thoryn-dev/Soundic-SD-01-Schematic/curves/chrominance.png

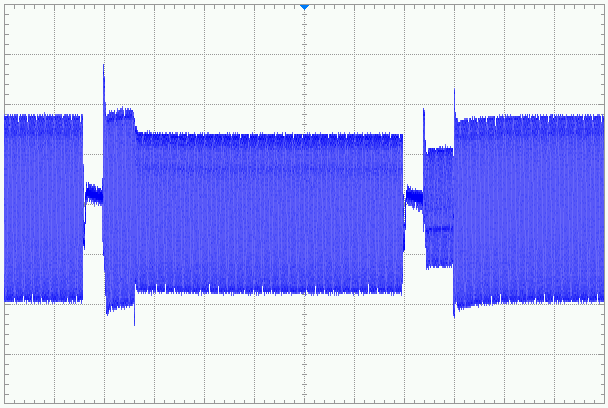
curves/chrominance.png
