thoryn-dev/Soundic-SD-01-Schematic/curves/clock.png

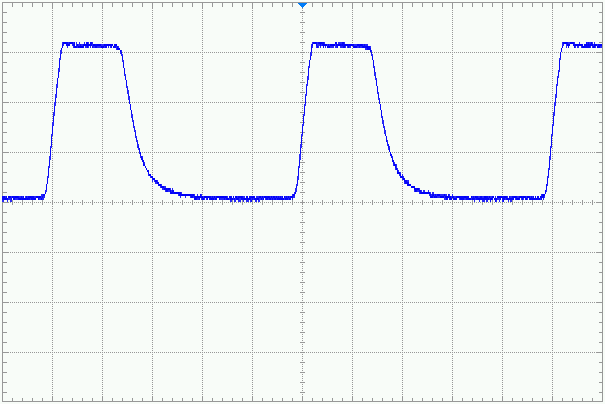
curves/clock.png
