thoryn-dev/Soundic-SD-01-Schematic/curves/Color Carrier.png

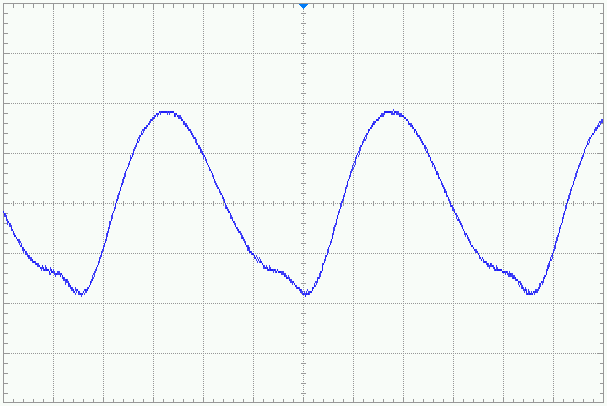
curves/Color Carrier.png
