thoryn-dev/Soundic-SD-01-Schematic/curves/horizontal sync.png

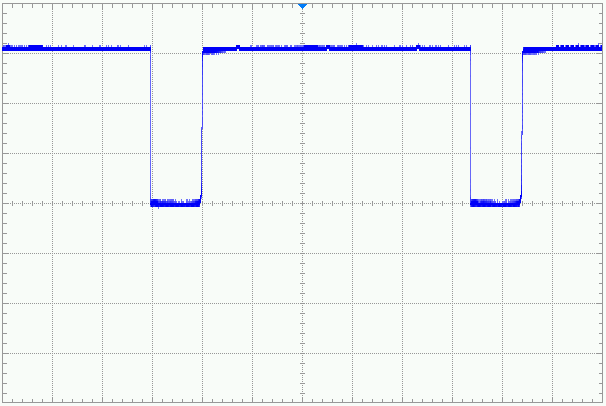
curves/horizontal sync.png
