thoryn-dev/Soundic-SD-01-Schematic/curves/lum+chrom.png

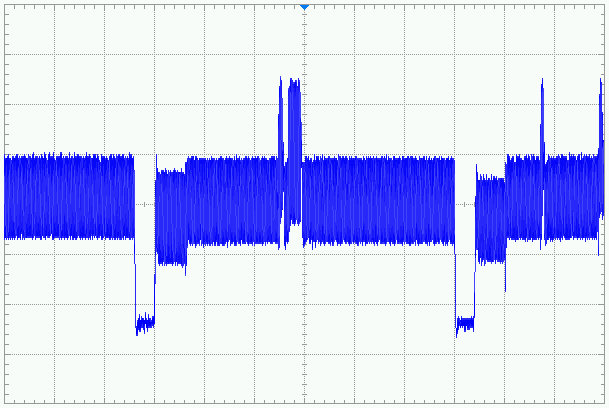
curves/lum+chrom.png
