thoryn-dev/Soundic-SD-01-Schematic/curves/Luminance.png

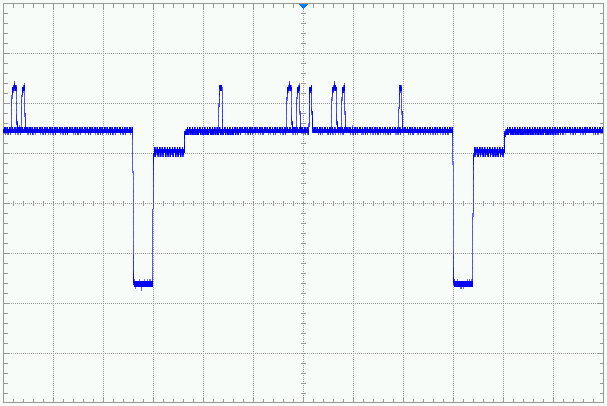
curves/Luminance.png
