thoryn-dev/Soundic-SD-01-Schematic/curves/phase reverse.png

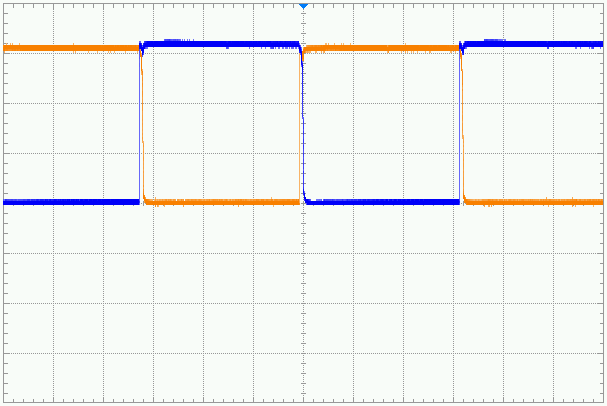
curves/phase reverse.png
