thoryn-dev/Soundic-SD-01-Schematic/pictures/football.gif

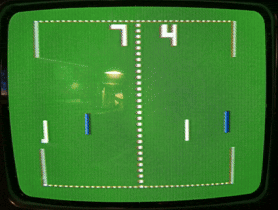
pictures/football.gif
