thoryn-dev/Soundic-SD-01-Schematic/pictures/main PCB traces side.jpg

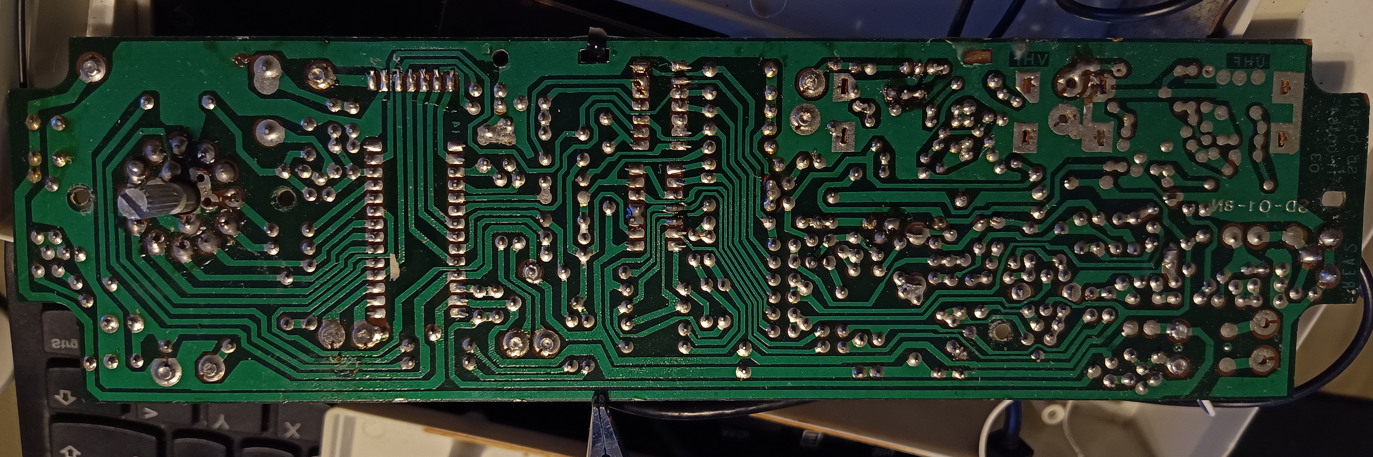
pictures/main PCB traces side.jpg
