thoryn-dev/Soundic-SD-01-Schematic/pictures/switch pcb.jpg

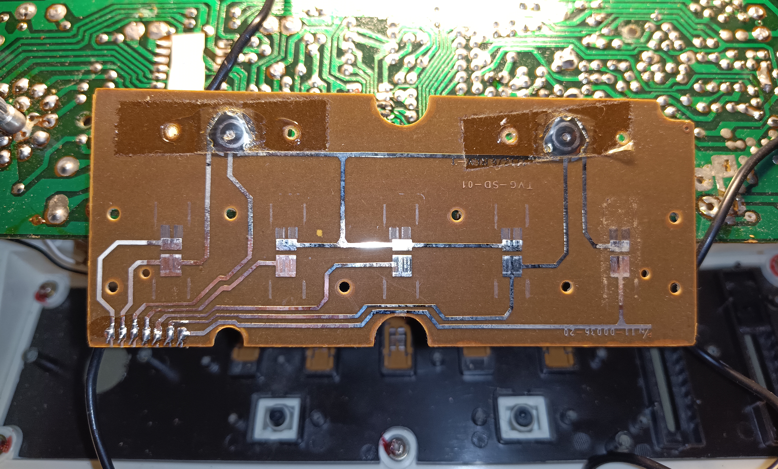
pictures/switch pcb.jpg
