thoryn-dev/Soundic-SD-01-Schematic/pictures/main PCB component side.jpg

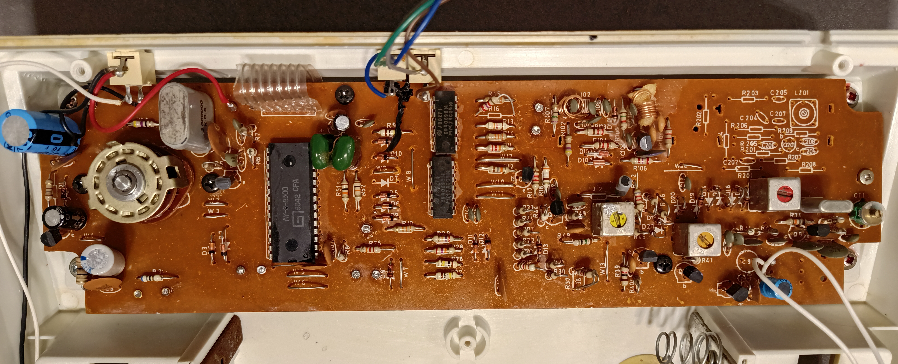
pictures/main PCB component side.jpg
