thoryn-dev/Soundic-SD-01-Schematic/pdfs/kicad_schematic.pdf

1 | 2 | 3 | 4 | 5 | 6 | 7 | 8 | 9

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
F Size: | KiCad E.D.A. 10.0.8 | 2026-10-30

# Title: TVS SD-01 PAL Color Console (Pong Clone)

Soundic | Project No.: | TVG-SD-01
| Schematic No.:
| A4 | Author: M. Fiedler | Date:
Sheet: | / | | Rev:
File: | kicad_schematic.kicad_sch | | Page:

### Main PCB: P/N 11-00164-03, Switch PCB: P/N 11-00036-20 The reverse engineering was performed on a console with serial number 16

### This document is licensed unter CC0 1.0 Universal

Video-Generation Datei: Video-Generation.kicad_sch Color-Modulator Datei: Color-Modulator.kicad_sch RF-Stage VHF Datei: RF-Stage VHF.kicad_sch CPU
Datei: CPU.kicad_sch | Symbol | Note Measurement point with measured value

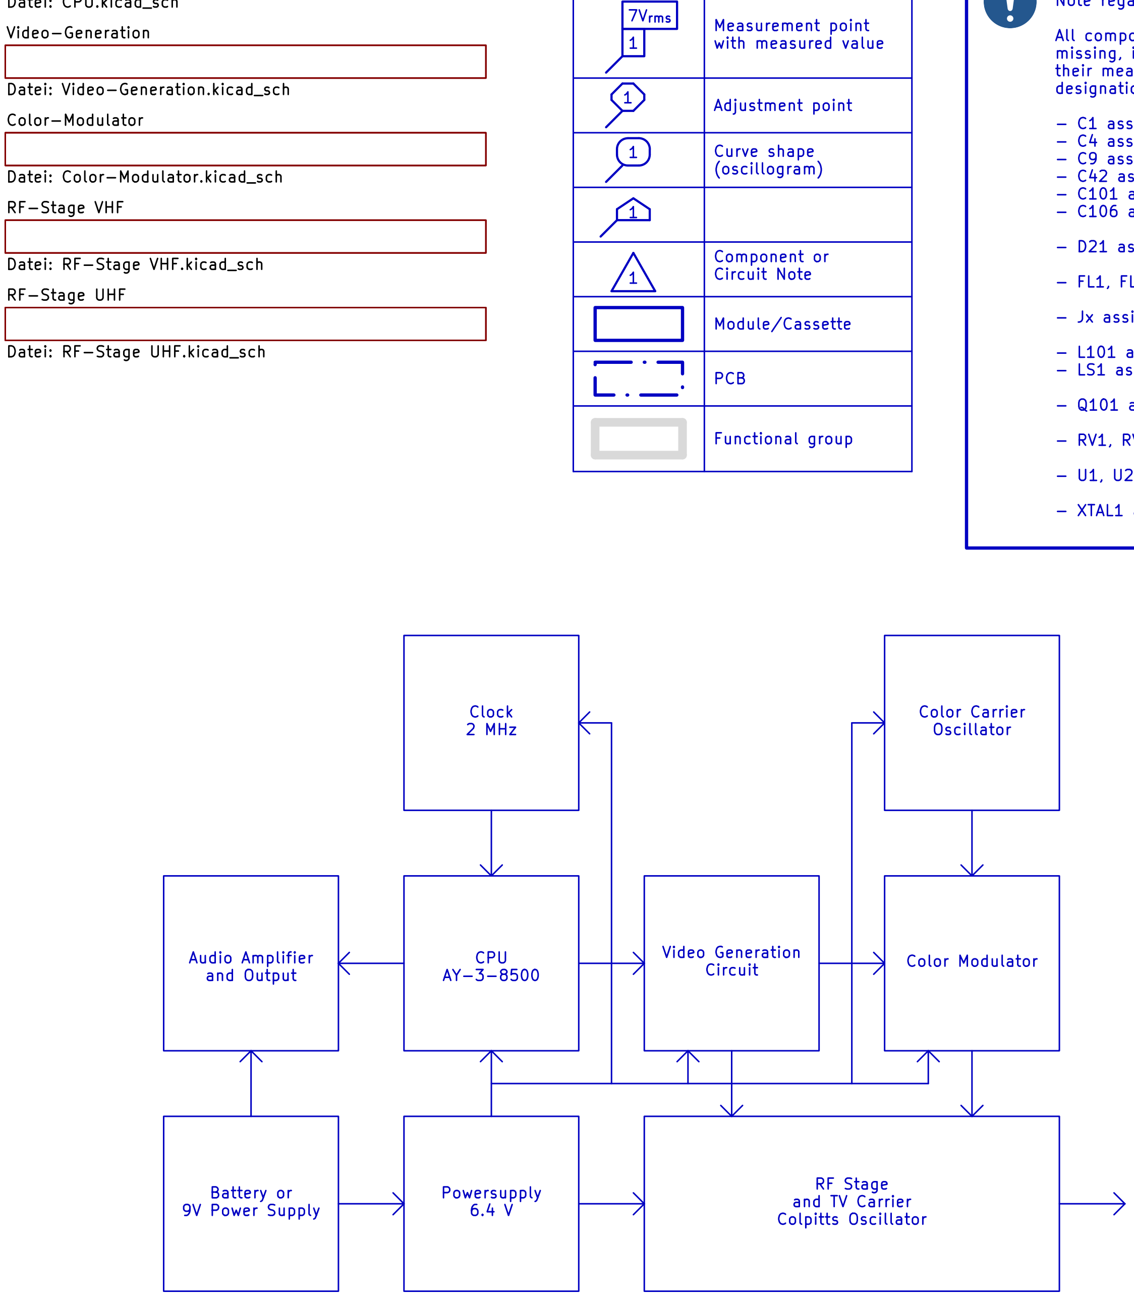
[picture p17: figure]
RF-Stage UHF Datei: RF-Stage UHF.kicad_sch; Adjustment point Curve shape; (oscillogram); 1 Battery or 9V Power Supply; Video Generation Circuit; 7Vrms Audio Amplifier and Output

Component or Circuit Note Module/Cassette PCB

# Functional group RF Stage and TV Carrier Colpitts Oscillator

1 Powersupply 6.4 V | Color Carrier Oscillator Clock 2 MHz CPU | Color Modulator AY-3-8500

All measurements with the oscilloscope were taken with

a 1:10 probe to avoid loading the RF circuits. Note regarding component names: All component designations written in red were either missing, illegible, or duplicated. I attempted to deduce

their meaning logically and have noted below which
designations this applies to. - C1 assigned because it is unreadable - C4 assigned because it is unreadable - C9 assigned because there is no label - C42 assigned because it is unreadable - C101 assigned because it is unreadable - C106 assigned because it is unreadable - D21 assigned because it is duplicated (D20) - FL1, FL2, FL3 assigned because they are unreadable - Jx assigned because there is no label - L101 assigned because it is unreadable - LS1 assigned because there is no label - Q101 assigned because it is unreadable - RV1, RV2 assigned because there are no labels - U1, U2, U3 assigned because they are unreadable - XTAL1 assigned because it is unreadable

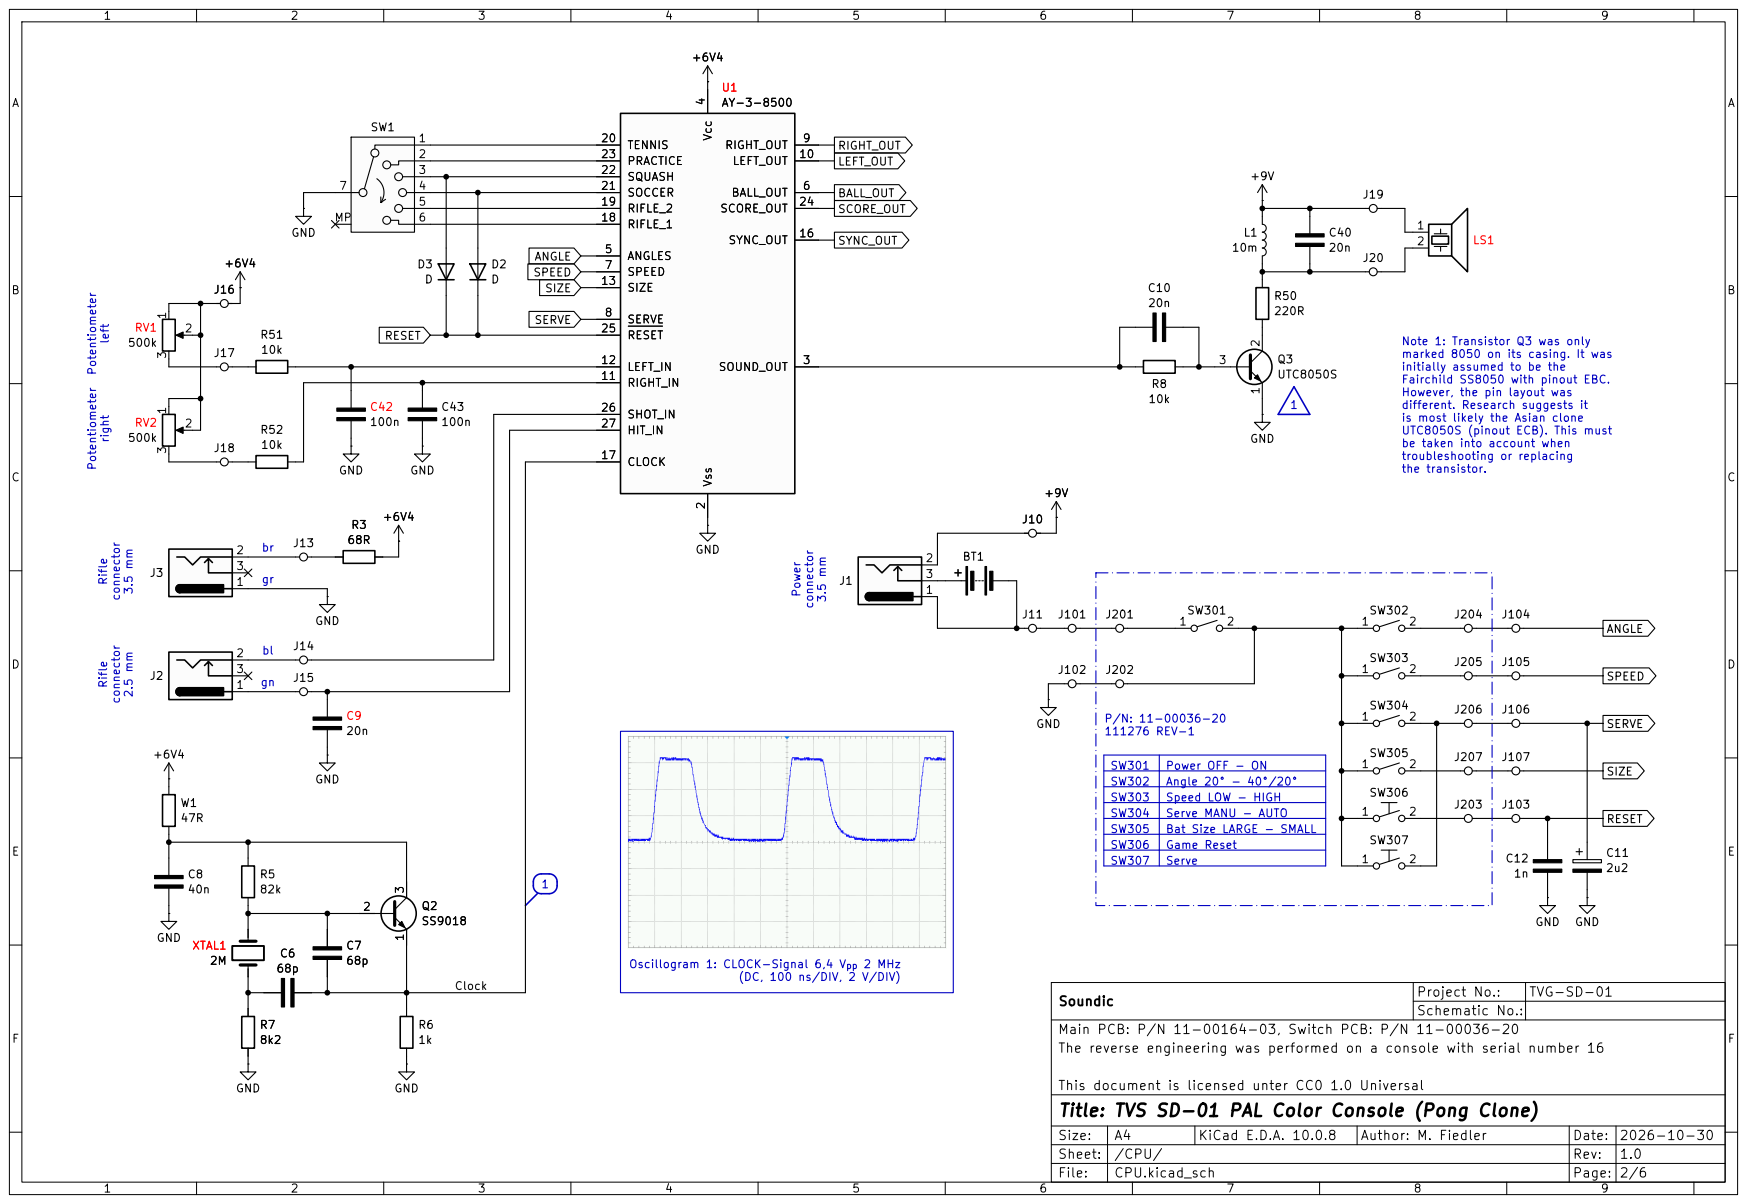
[picture p18: page 2]

initially assumed to be the
Fairchild SS8050 with pinout EBC. However, the pin layout was different. Research suggests it

is most likely the Asian clone UTC8050S (pinout ECB). This must be taken into account when

111276 REV-1 Oscillogram 1: CLOCK-Signal 6,4 Vpp 2 MHz

SW302 | Angle 20° - 40°/20° SW303 Speed LOW - HIGH

SW304 | Serve MANU - AUTO

Soundic | Project No.: | TVG-SD-01

Schematic No.:

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

This document is licensed unter CC0 1.0 Universal
Title: TVS SD-01 PAL Color Console (Pong Clone)

A4 | Author: M. Fiedler | Date:
/CPU/
CPU.kicad_sch

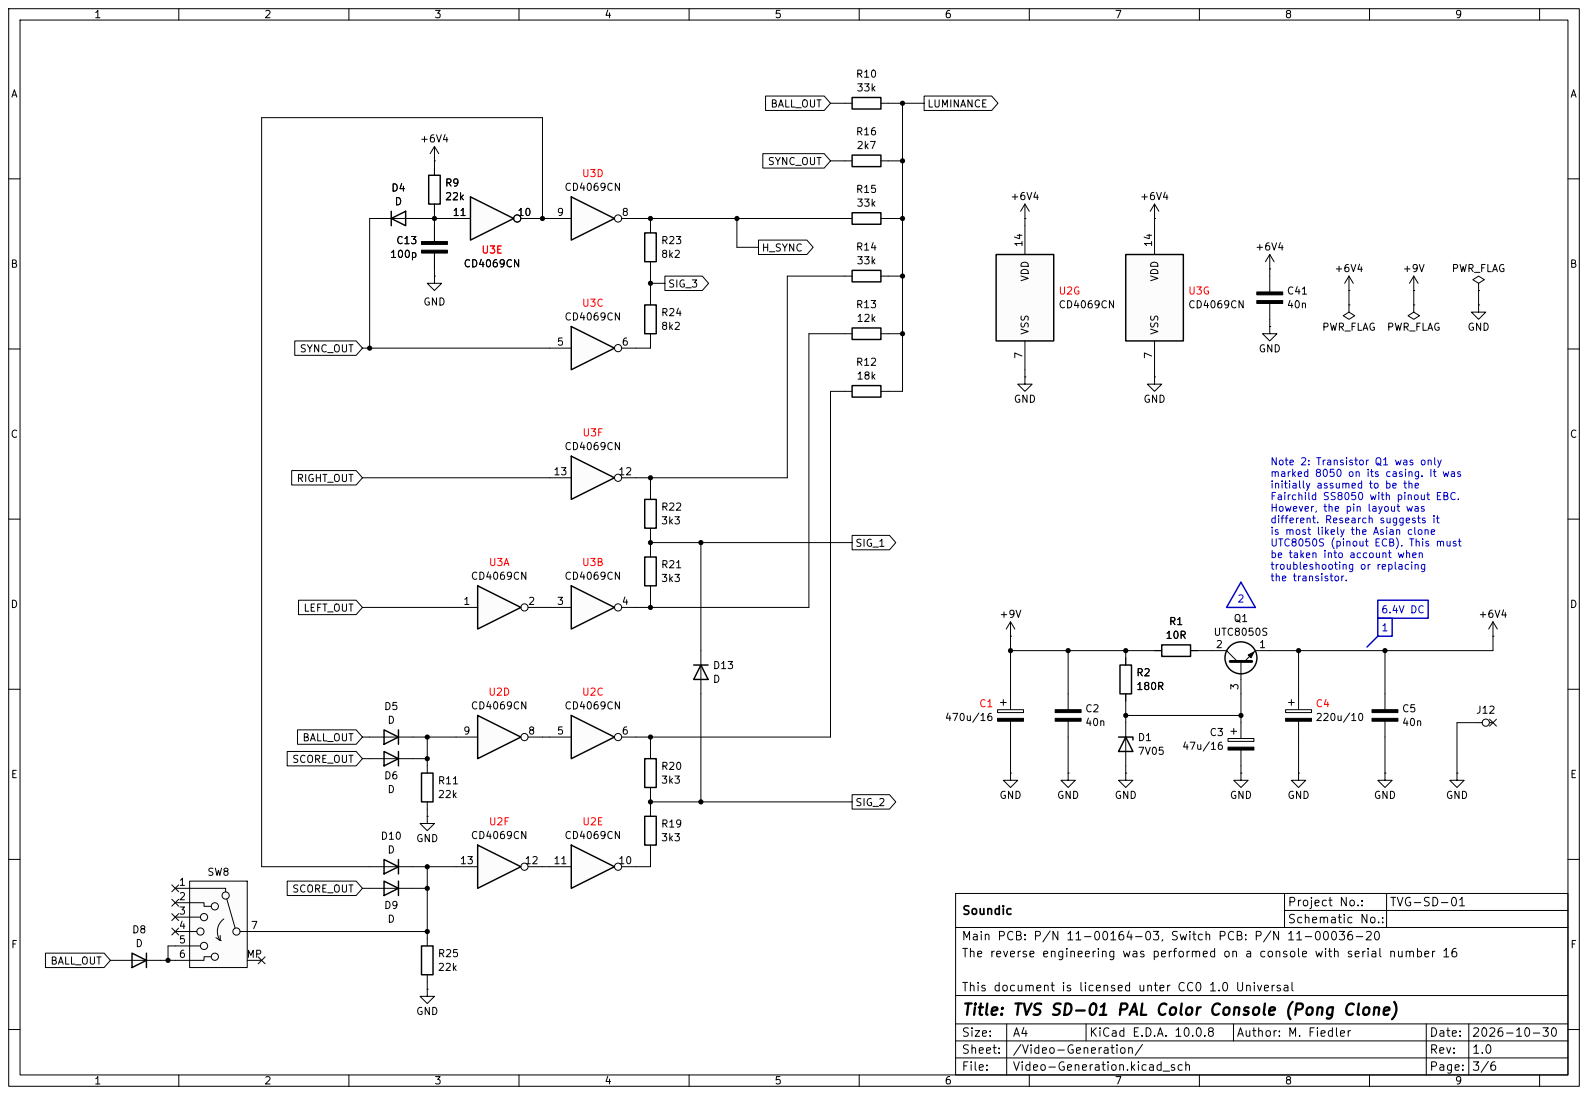
[picture p19: page 3]
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

is most likely the Asian clone UTC8050S (pinout ECB). This must be taken into account when

Soundic | Project No.: | TVG-SD-01

Schematic No.:

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

A4 | Author: M. Fiedler | Date:
/Video-Generation/
Video-Generation.kicad_sch

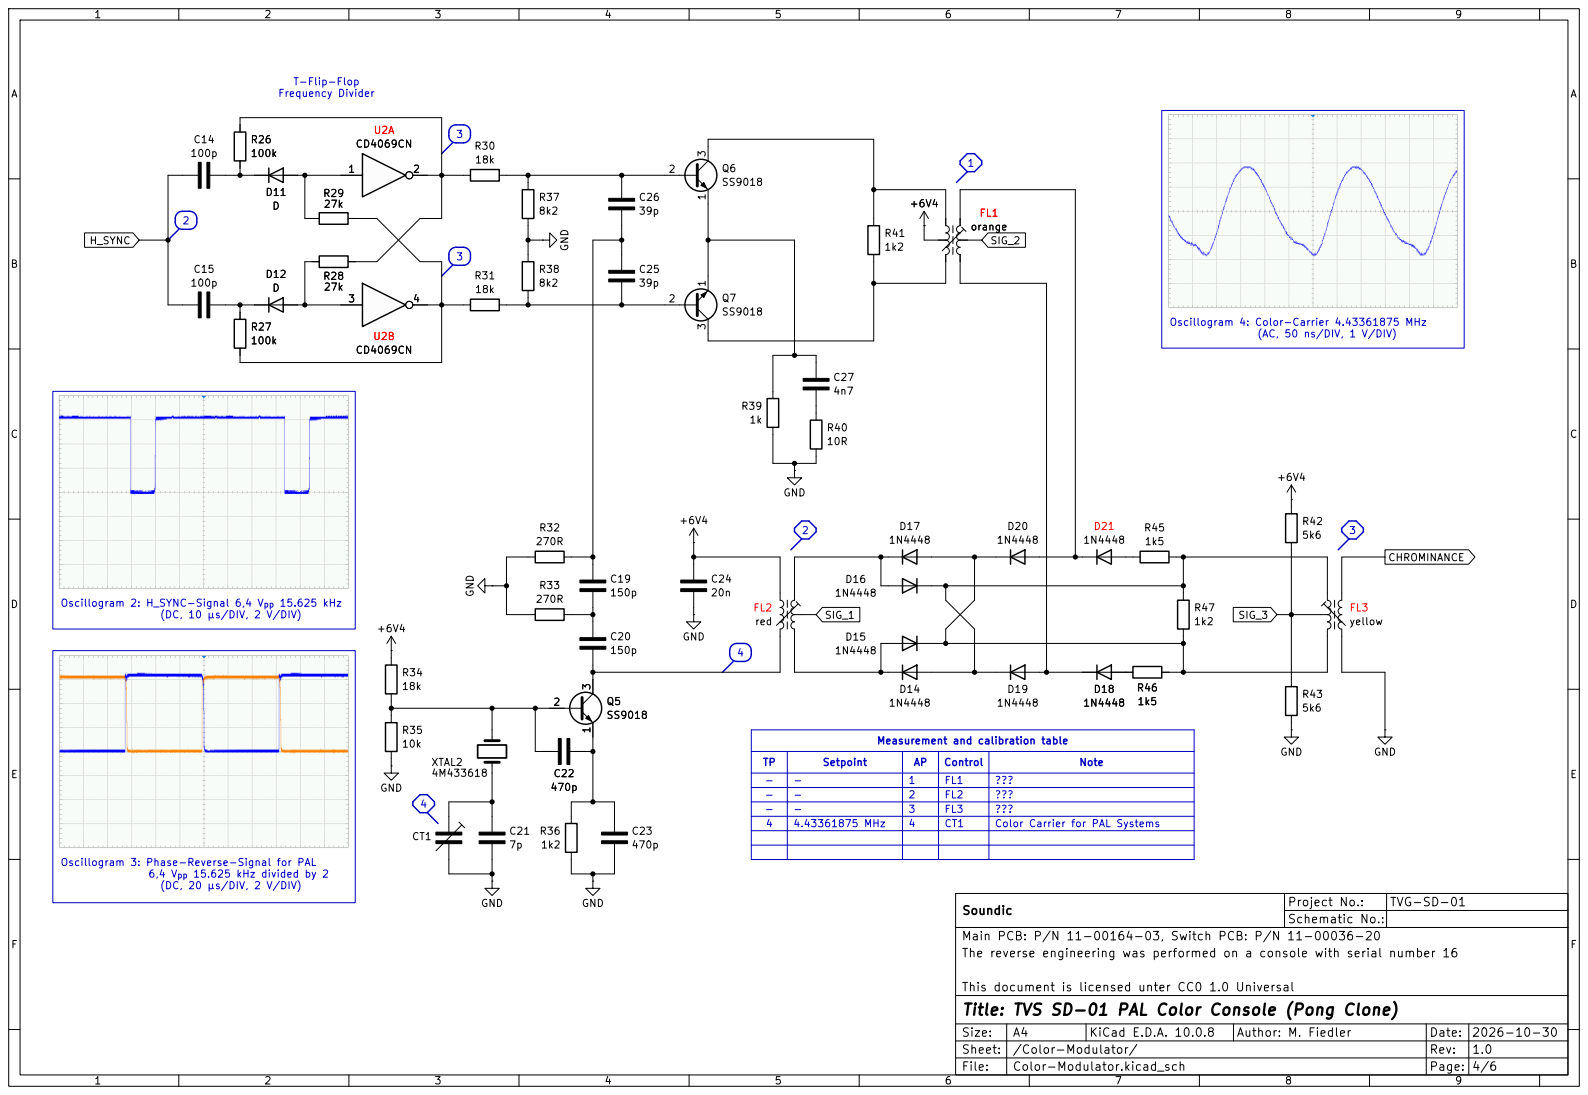
[picture p20: page 4]

3 Oscillogram 2: H_SYNC-Signal 6,4 Vpp 15.625 kHz

3 Oscillogram 4: Color-Carrier 4.43361875 MHz

(DC, 20 µs/DIV, 2 V/DIV)

Soundic | Project No.: | TVG-SD-01

Schematic No.:

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

A4 | Author: M. Fiedler | Date:
/Color-Modulator/
Color-Modulator.kicad_sch

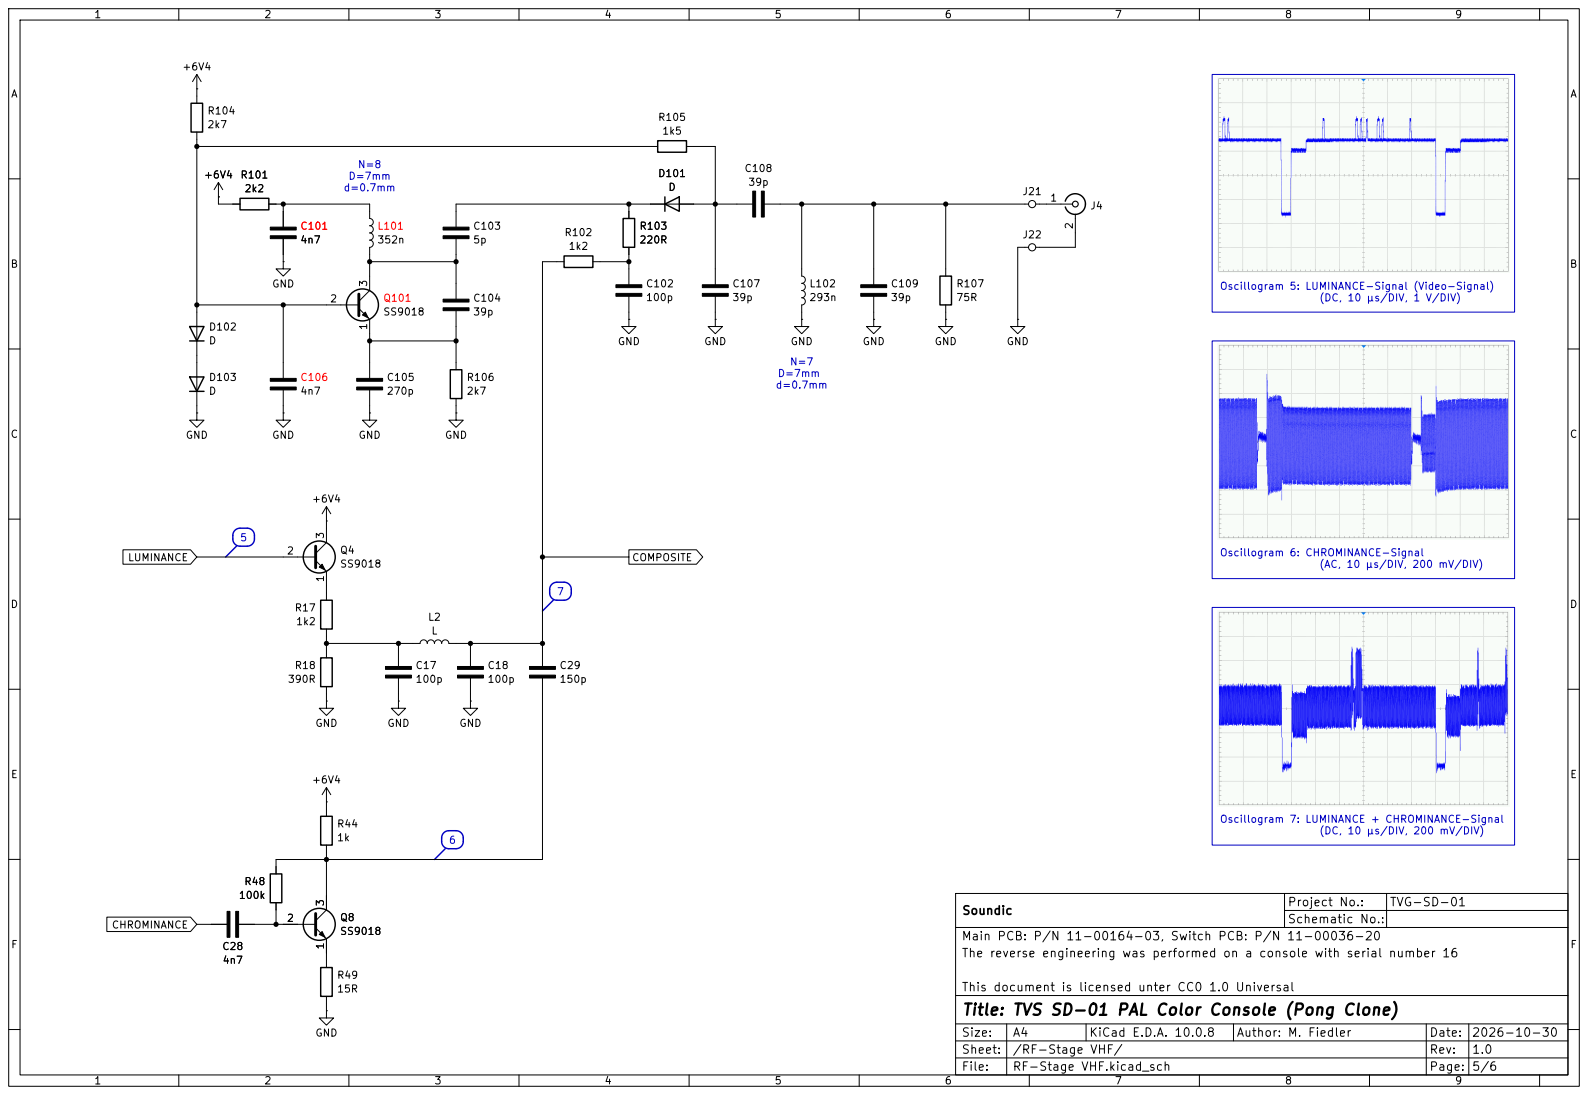
[picture p21: page 5]

(DC, 10 µs/DIV, 1 V/DIV) N=7 D=7mm d=0.7mm

Oscillogram 5: LUMINANCE-Signal (Video-Signal)

Soundic | Project No.: | TVG-SD-01

Schematic No.:

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

A4 | Author: M. Fiedler | Date:
/RF-Stage VHF/
RF-Stage VHF.kicad_sch

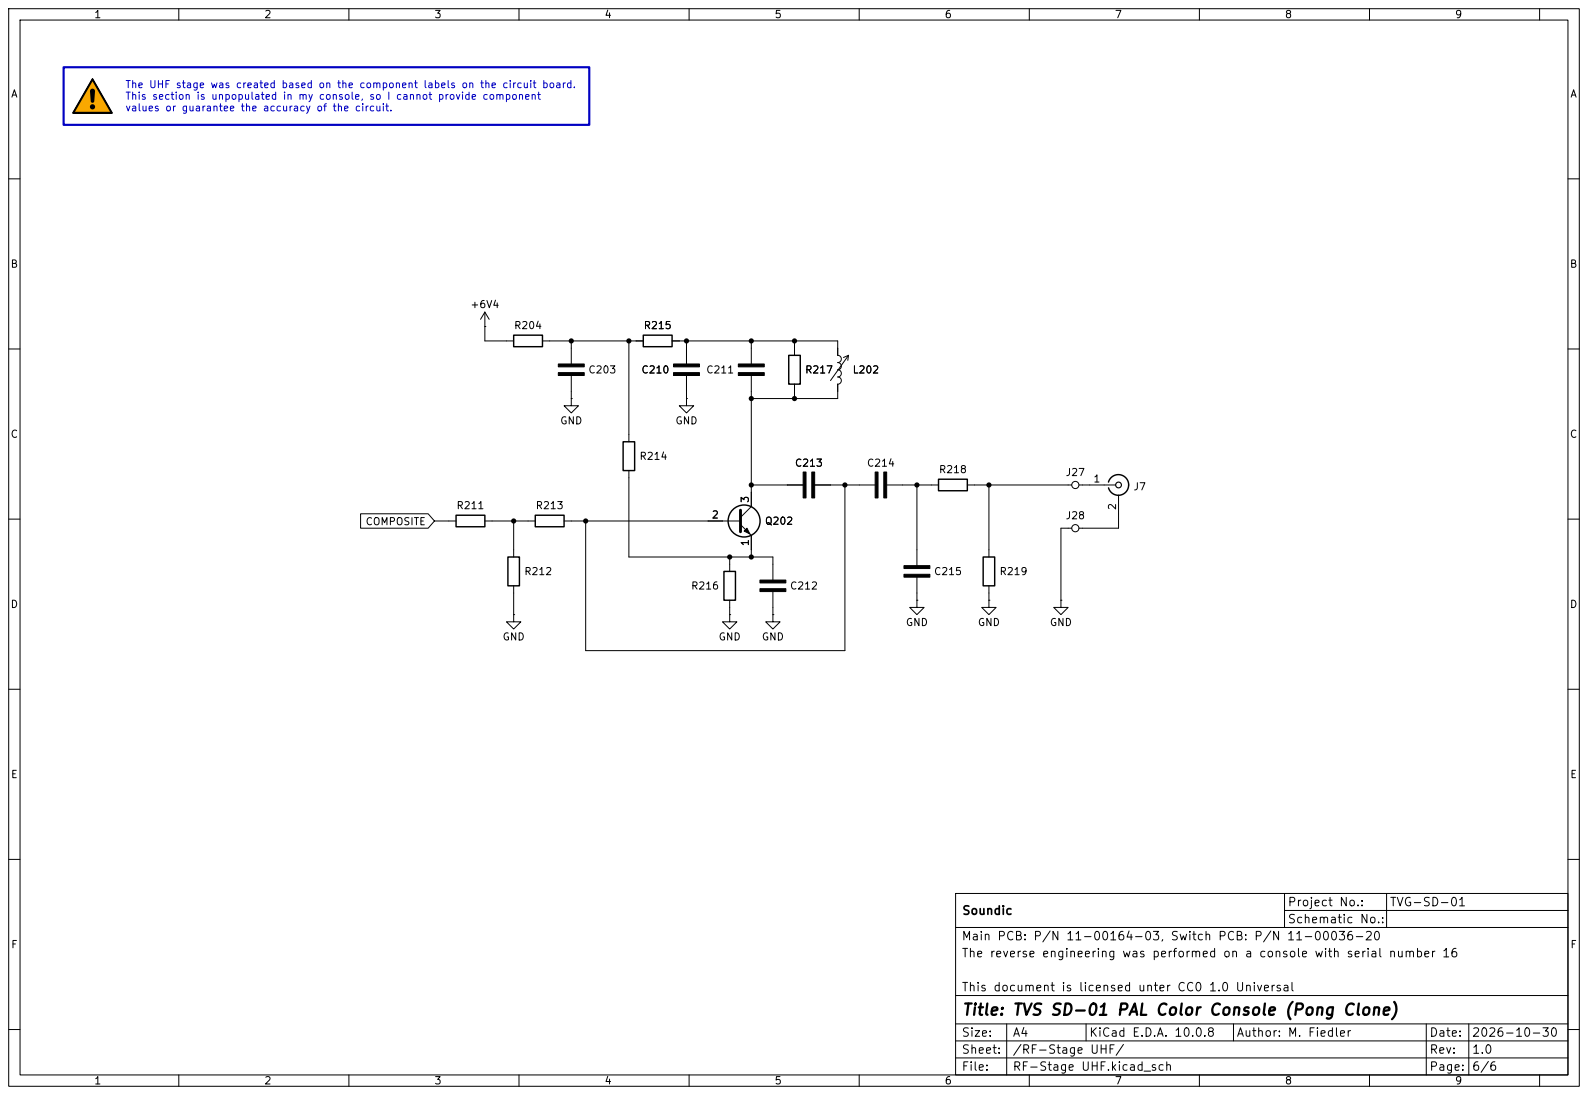
[picture p22: page 6]

Soundic | Project No.: | TVG-SD-01

Schematic No.:

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

A4 | Author: M. Fiedler | Date:
/RF-Stage UHF/
RF-Stage UHF.kicad_sch
