thoryn-dev/Soundic-SD-01-Schematic/pdfs/Layout_main.pdf

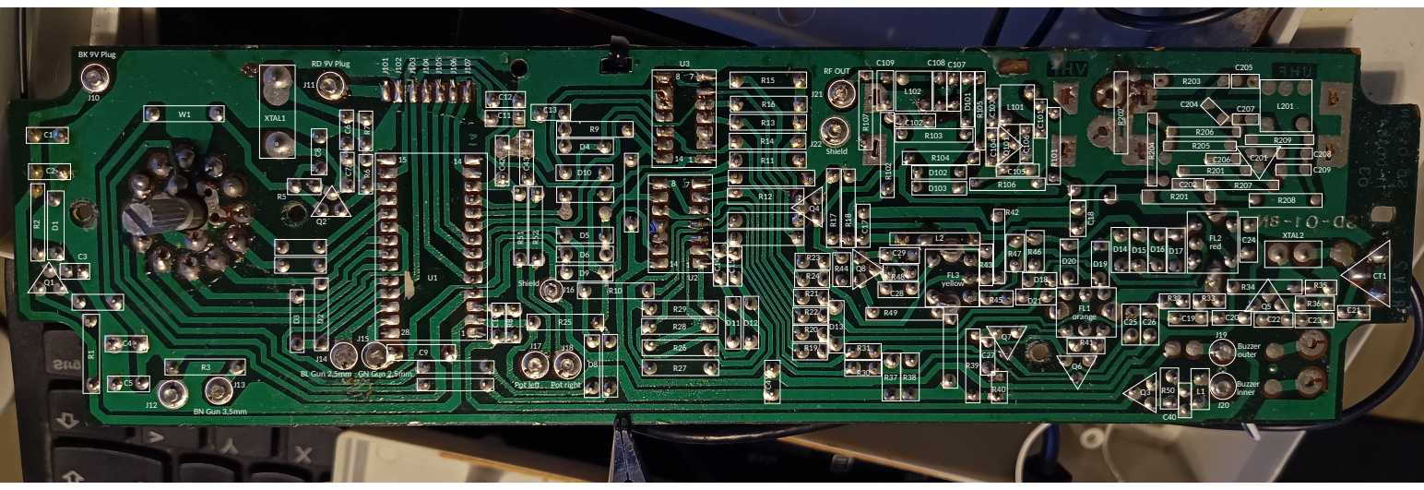
[picture p23: page 1]

BL Gun 2,5mm GN Gun 2,5mm
