thoryn-dev/Soundic-SD-01-Schematic/pdfs/Layout_switch.pdf

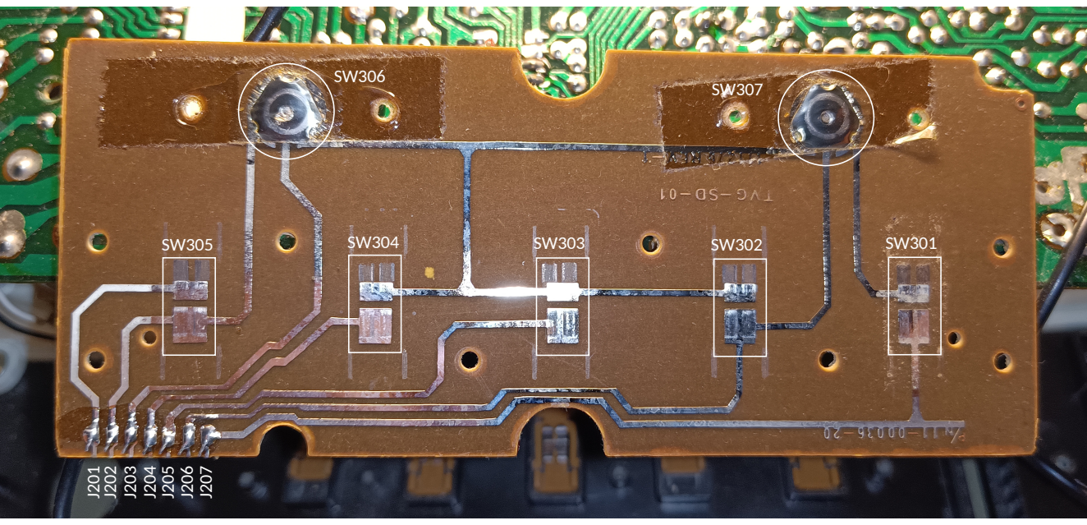
[picture p24: page 1]
