thoryn-dev/Soundic-SD-01-Schematic/kicad_schematic/CPU.kicad_sch

## KiCad design kicad_schematic/CPU.kicad_sch (2026-11-07, an earlier design)

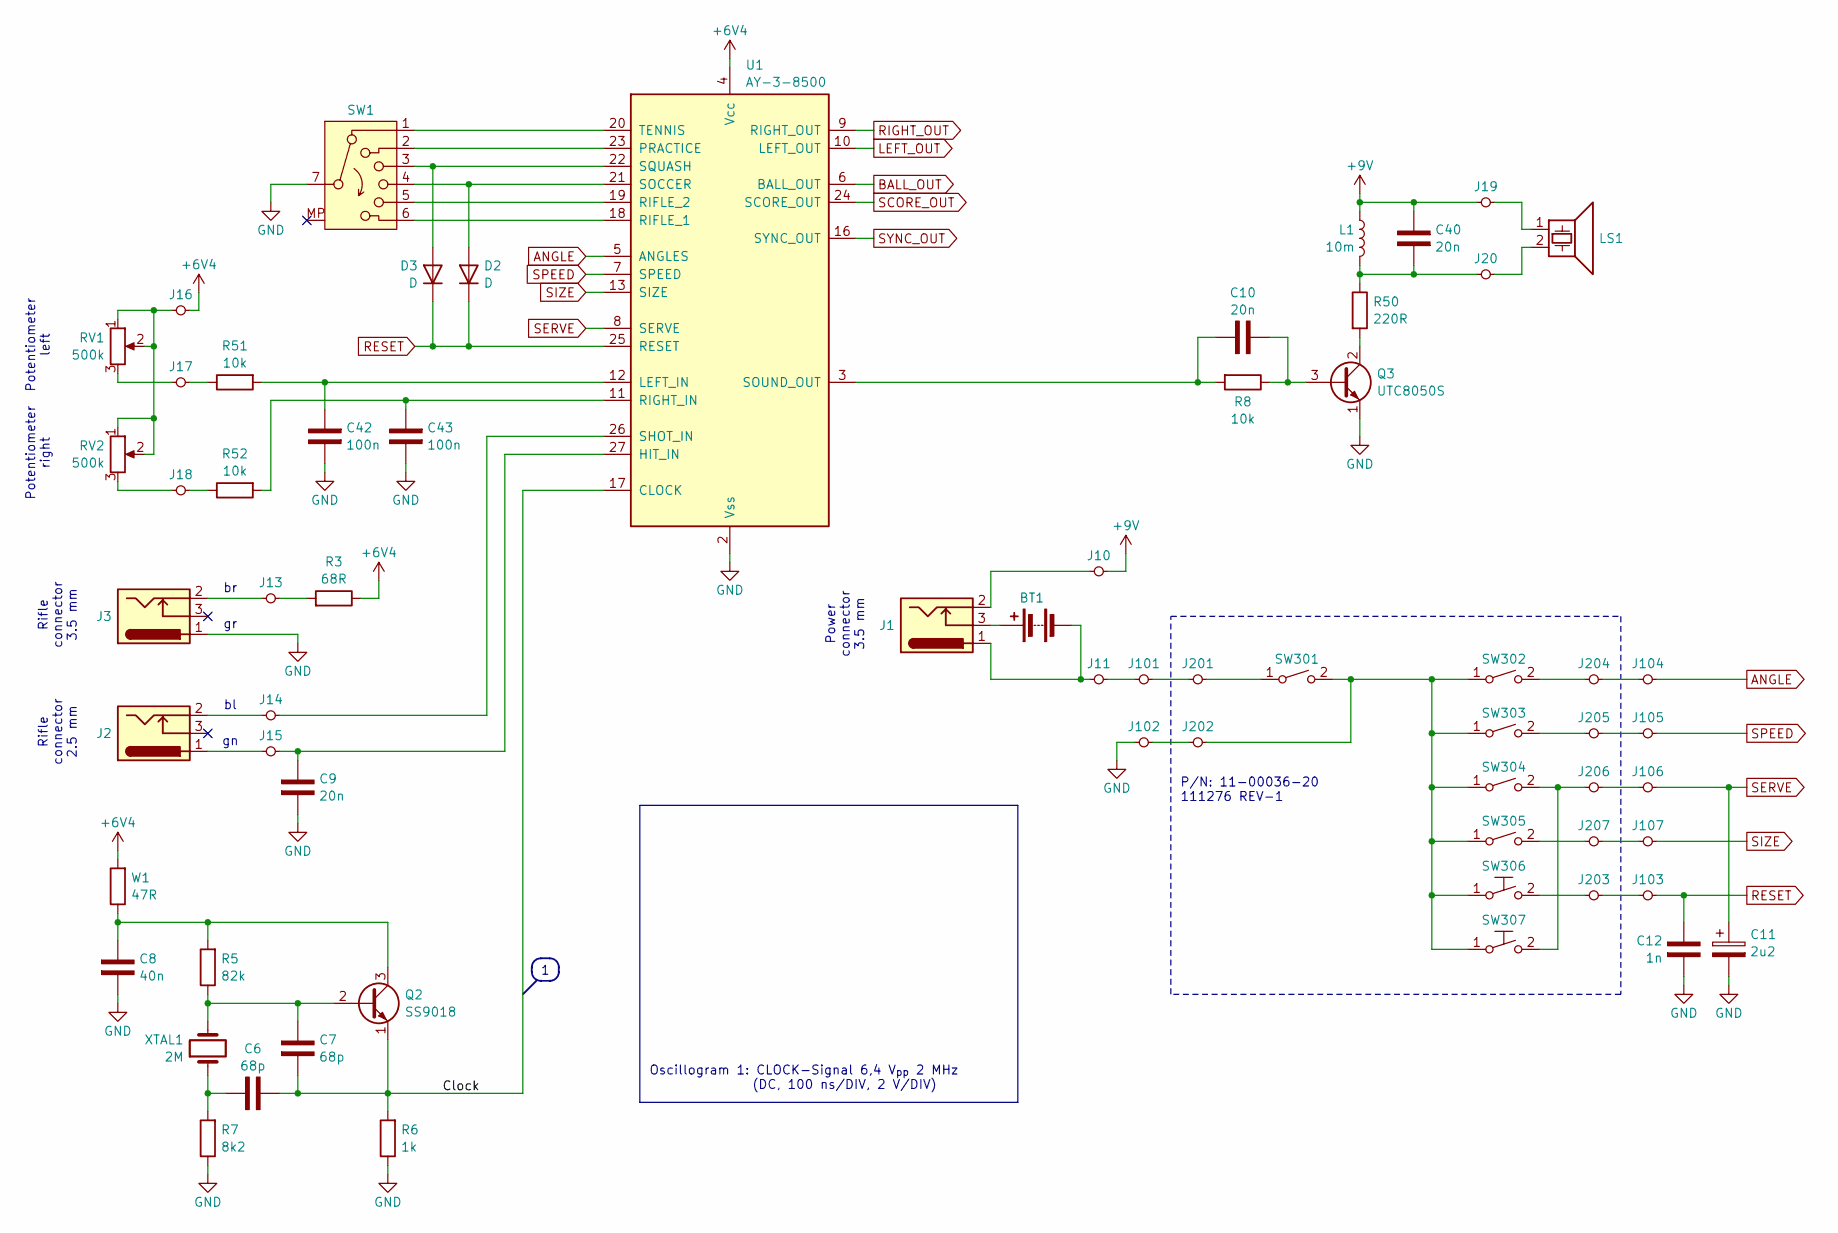
[picture p25: schematic CPU.kicad_sch]

Parts:
BT1: 9V
C6, C7: 68p
C8: 40n
C9, C10, C40: 20n
C11: 2u2
C12: 1n
C42, C43: 100n
D2, D3: D
J1, J2, J3: Barrel_Jack_Switch
J10, J11, J13, J14, J15, J16, J17, J18, J19, J20, J101, J102, J103, J104, J105, J106, J107, J201, J202, J203, J204, J205, J206, J207: PCB_Conn
L1: 10m
LS1: Speaker_Crystal
Q2: SS9018
Q3: UTC8050S
R3: 68R
R5: 82k
R6: 1k
R7: 8k2
R8, R51, R52: 10k
R50: 220R
RV1, RV2: 500k
SW1: SW_Rotary_1x6_MP
SW301, SW302, SW303, SW304, SW305: SW_1P1T
SW306, SW307: SW_PUSH_1PST
U1: AY-3-8500
W1: 47R
XTAL1: 2M

Connections:
+6V4: J16.1 (intern), R3.1, U1.4 (Vcc), W1.2
+9V: C40.2, J10.2 (Extern), J19.2 (Extern), L1.1
ANGLE: J104.2 (Extern), U1.5 (ANGLES)
BALL_OUT: U1.6 (BALL_OUT)
Clock: C6.2, C7.2, Q2.1 (E), R6.2, U1.17 (CLOCK)
GND: C8.2, C9.2, C11.2, C12.2, C42.2, C43.2, J3.1, J102.1 (intern), Q3.1 (E), R6.1, R7.1, SW1.7, U1.2 (Vss)
LEFT_OUT: U1.10 (LEFT_OUT)
unnamed: BT1.1 (+), J1.3
unnamed: BT1.2 (-), J1.1, J11.1 (intern)
unnamed: C6.1, R7.2, XTAL1.1
unnamed: C7.1, Q2.2 (B), R5.1, XTAL1.2
unnamed: C8.1, Q2.3 (C), R5.2, W1.1
unnamed: C9.1, J15.2 (Extern), U1.27 (HIT_IN)
unnamed: C10.1, R8.2, U1.3 (SOUND_OUT)
unnamed: C10.2, Q3.3 (B), R8.1
unnamed: C40.1, J20.2 (Extern), L1.2, R50.1
unnamed: C42.1, R51.2, U1.12 (LEFT_IN)
unnamed: C43.1, R52.2, U1.11 (RIGHT_IN)
unnamed: D2.2 (A), SW1.4, U1.21 (SOCCER)
unnamed: D3.2 (A), SW1.3, U1.22 (SQUASH)
unnamed: J1.2, J10.1 (intern)
unnamed: J13.1 (intern), R3.2
unnamed: J3.2, J13.2 (Extern)
unnamed: J2.2, J14.1 (intern)
unnamed: J14.2 (Extern), U1.26 (SHOT_IN)
unnamed: J2.1, J15.1 (intern)
unnamed: J16.2 (Extern), RV1.1, RV1.2, RV2.1, RV2.2
unnamed: J17.1 (intern), R51.1
unnamed: J17.2 (Extern), RV1.3
unnamed: J18.1 (intern), R52.1
unnamed: J18.2 (Extern), RV2.3
unnamed: J19.1 (intern), LS1.1
unnamed: J20.1 (intern), LS1.2
unnamed: J11.2 (Extern), J101.1 (intern)
unnamed: J101.2 (Extern), J201.1 (intern)
unnamed: J102.2 (Extern), J202.1 (intern)
unnamed: J103.1 (intern), J203.2 (Extern)
unnamed: J104.1 (intern), J204.2 (Extern)
unnamed: J105.1 (intern), J205.2 (Extern)
unnamed: J106.1 (intern), J206.2 (Extern)
unnamed: J107.1 (intern), J207.2 (Extern)
unnamed: J201.2 (Extern), SW301.1 (A)
unnamed: J202.2 (Extern), SW301.2 (B), SW302.1 (A), SW303.1 (A), SW304.1 (A), SW305.1 (A), SW306.1 (A), SW307.1 (A)
unnamed: J203.1 (intern), SW306.2 (B)
unnamed: J204.1 (intern), SW302.2 (B)
unnamed: J205.1 (intern), SW303.2 (B)
unnamed: J206.1 (intern), SW304.2 (B), SW307.2 (B)
unnamed: J207.1 (intern), SW305.2 (B)
unnamed: Q3.2 (C), R50.2
unnamed: SW1.1, U1.20 (TENNIS)
unnamed: SW1.2, U1.23 (PRACTICE)
unnamed: SW1.5, U1.19 (RIFLE_2)
unnamed: SW1.6, U1.18 (RIFLE_1)
RESET: C12.1, D2.1 (K), D3.1 (K), J103.2 (Extern), U1.25 (RESET)
RIGHT_OUT: U1.9 (RIGHT_OUT)
SCORE_OUT: U1.24 (SCORE_OUT)
SERVE: C11.1, J106.2 (Extern), U1.8 (SERVE)
SIZE: J107.2 (Extern), U1.13 (SIZE)
SPEED: J105.2 (Extern), U1.7 (SPEED)
SYNC_OUT: U1.16 (SYNC_OUT)

Notes on the sheet:
P/N: 11-00036-20 111276 REV-1
Rifle connector 3.5 mm
Oscillogram 1: CLOCK-Signal 6,4 V_{pp} 2 MHz (DC, 100 ns/DIV, 2 V/DIV)
Rifle connector 2.5 mm
Potentiometer left
Power connector 3.5 mm
Potentiometer right
