thoryn-dev/Soundic-SD-01-Schematic/kicad_schematic/Color-Modulator.kicad_sch

## KiCad design kicad_schematic/Color-Modulator.kicad_sch (2026-11-07, an earlier design)

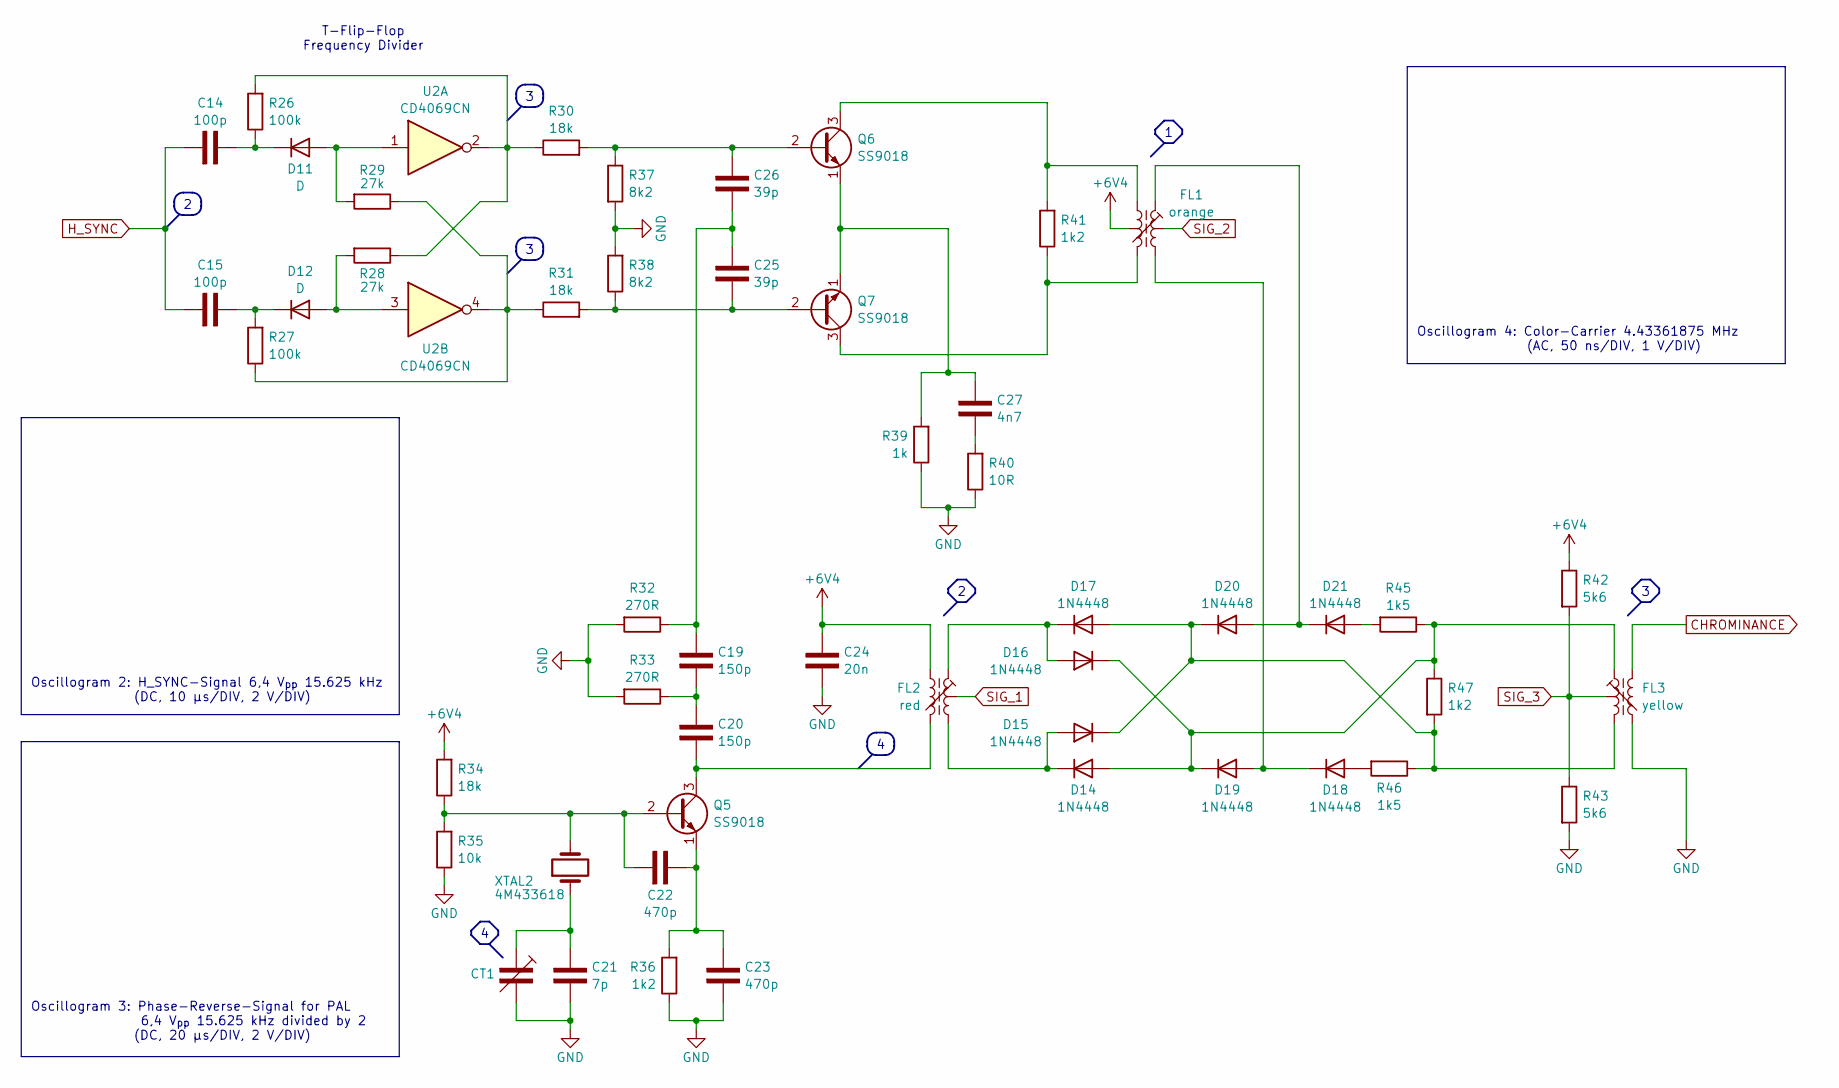
[picture p26: schematic Color-Modulator.kicad_sch]

Parts:
C14, C15: 100p
C19, C20: 150p
C21: 7p
C22, C23: 470p
C24: 20n
C25, C26: 39p
C27: 4n7
CT1: C_Trim
D11, D12: D
D14, D15, D16, D17, D18, D19, D20, D21: 1N4448
FL1: orange
FL2: red
FL3: yellow
Q5, Q6, Q7: SS9018
R26, R27: 100k
R28, R29: 27k
R30, R31, R34: 18k
R32, R33: 270R
R35: 10k
R36, R41, R47: 1k2
R37, R38: 8k2
R39: 1k
R40: 10R
R42, R43: 5k6
R45, R46: 1k5
U2: CD4069CN
XTAL2: 4M433618

Connections:
+6V4: C24.1, FL1.2, FL2.1, R34.2, R42.1
CHROMINANCE: FL3.1
GND: C21.2, C23.2, C24.2, CT1.2, FL3.2, R32.2, R33.2, R35.1, R36.1, R37.2, R38.2, R39.1, R40.1, R43.2
H_SYNC: C14.1, C15.1
unnamed: C14.2, D11.1 (K), R26.1
unnamed: C15.2, D12.1 (K), R27.2
unnamed: C19.1, C25.1, C26.2, R32.1
unnamed: C19.2, C20.1, R33.1
unnamed: C20.2, FL2.2, Q5.3 (C)
unnamed: C21.1, CT1.1, XTAL2.1
unnamed: C22.1, Q5.2 (B), R34.1, R35.2, XTAL2.2
unnamed: C22.2, C23.1, Q5.1 (E), R36.2
unnamed: C25.2, Q7.2 (B), R31.2, R38.1
unnamed: C26.1, Q6.2 (B), R30.2, R37.1
unnamed: C27.1, Q6.1 (E), Q7.1 (E), R39.2
unnamed: C27.2, R40.2
unnamed: D11.2 (A), R29.2, U2.1
unnamed: D12.2 (A), R28.2, U2.3
unnamed: D14.1 (K), D15.2 (A), FL2.5
unnamed: D14.2 (A), D16.1 (K), D19.1 (K), FL3.3, R45.1, R47.1
unnamed: D15.1 (K), D17.2 (A), D20.1 (K), FL3.5, R46.1, R47.2
unnamed: D16.2 (A), D17.1 (K), FL2.3
unnamed: D18.1 (K), D19.2 (A), FL1.6
unnamed: D18.2 (A), R46.2
unnamed: D20.2 (A), D21.1 (K), FL1.4
unnamed: D21.2 (A), R45.2
unnamed: FL1.1, Q6.3 (C), R41.2
unnamed: FL1.3, Q7.3 (C), R41.1
unnamed: R26.2, R28.1, R30.1, U2.2
unnamed: R27.1, R29.1, R31.1, U2.4
SIG_1: FL2.4
SIG_2: FL1.5
SIG_3: FL3.4, R42.2, R43.1

Notes on the sheet:
Oscillogram 2: H_SYNC-Signal 6,4 V_{pp} 15.625 kHz (DC, 10 µs/DIV, 2 V/DIV)
T-Flip-Flop Frequency Divider
Oscillogram 4: Color-Carrier 4.43361875 MHz (AC, 50 ns/DIV, 1 V/DIV)
Oscillogram 3: Phase-Reverse-Signal for PAL 6,4 V_{pp} 15.625 kHz divided by 2 (DC, 20 µs/DIV, 2 V/DIV)
