thoryn-dev/Soundic-SD-01-Schematic/kicad_schematic/RF-Stage UHF.kicad_sch

## KiCad design kicad_schematic/RF-Stage UHF.kicad_sch (2026-11-07, an earlier design)

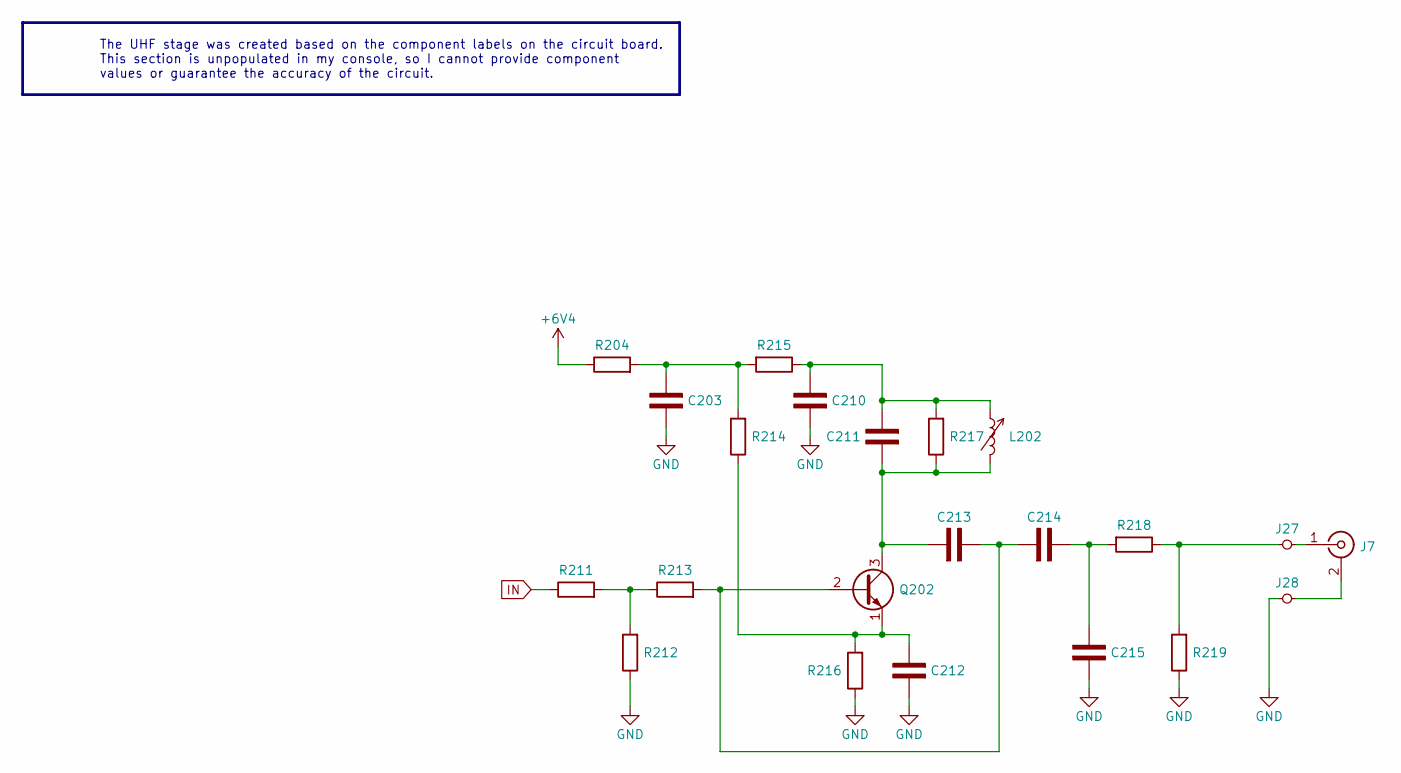
[picture p27: schematic RF-Stage UHF.kicad_sch]

Parts:
C203, C210, C211, C212, C213, C214, C215: (no value)
J7: Conn_Coaxial
J27, J28: PCB_Conn
L202: (no value)
Q202: (no value)
R204, R211, R212, R213, R214, R215, R216, R217, R218, R219: (no value)

Connections:
+6V4: R204.1
GND: C203.1, C210.1, C212.1, C215.2, J28.2 (Extern), R212.1, R216.1, R219.1
IN: R211.1
unnamed: C203.2, R204.2, R214.2, R215.2
unnamed: C210.2, C211.2, L202.1, R215.1, R217.2
unnamed: C211.1, C213.1, L202.2, Q202.3 (C), R217.1
unnamed: C212.2, Q202.1 (E), R214.1, R216.2
unnamed: C213.2, C214.1, Q202.2 (B), R213.2
unnamed: C214.2, C215.1, R218.2
unnamed: J7.1 (In), J27.1 (intern)
unnamed: J27.2 (Extern), R218.1, R219.2
unnamed: J7.2 (Ext), J28.1 (intern)
unnamed: R211.2, R212.2, R213.1

Notes on the sheet:
The UHF stage was created based on the component labels on the circuit board. This section is unpopulated in my console, so I cannot provide component values   or guarantee the accuracy of the circuit.
