thoryn-dev/Soundic-SD-01-Schematic/kicad_schematic/RF-Stage VHF.kicad_sch

## KiCad design kicad_schematic/RF-Stage VHF.kicad_sch (2026-11-07, an earlier design)

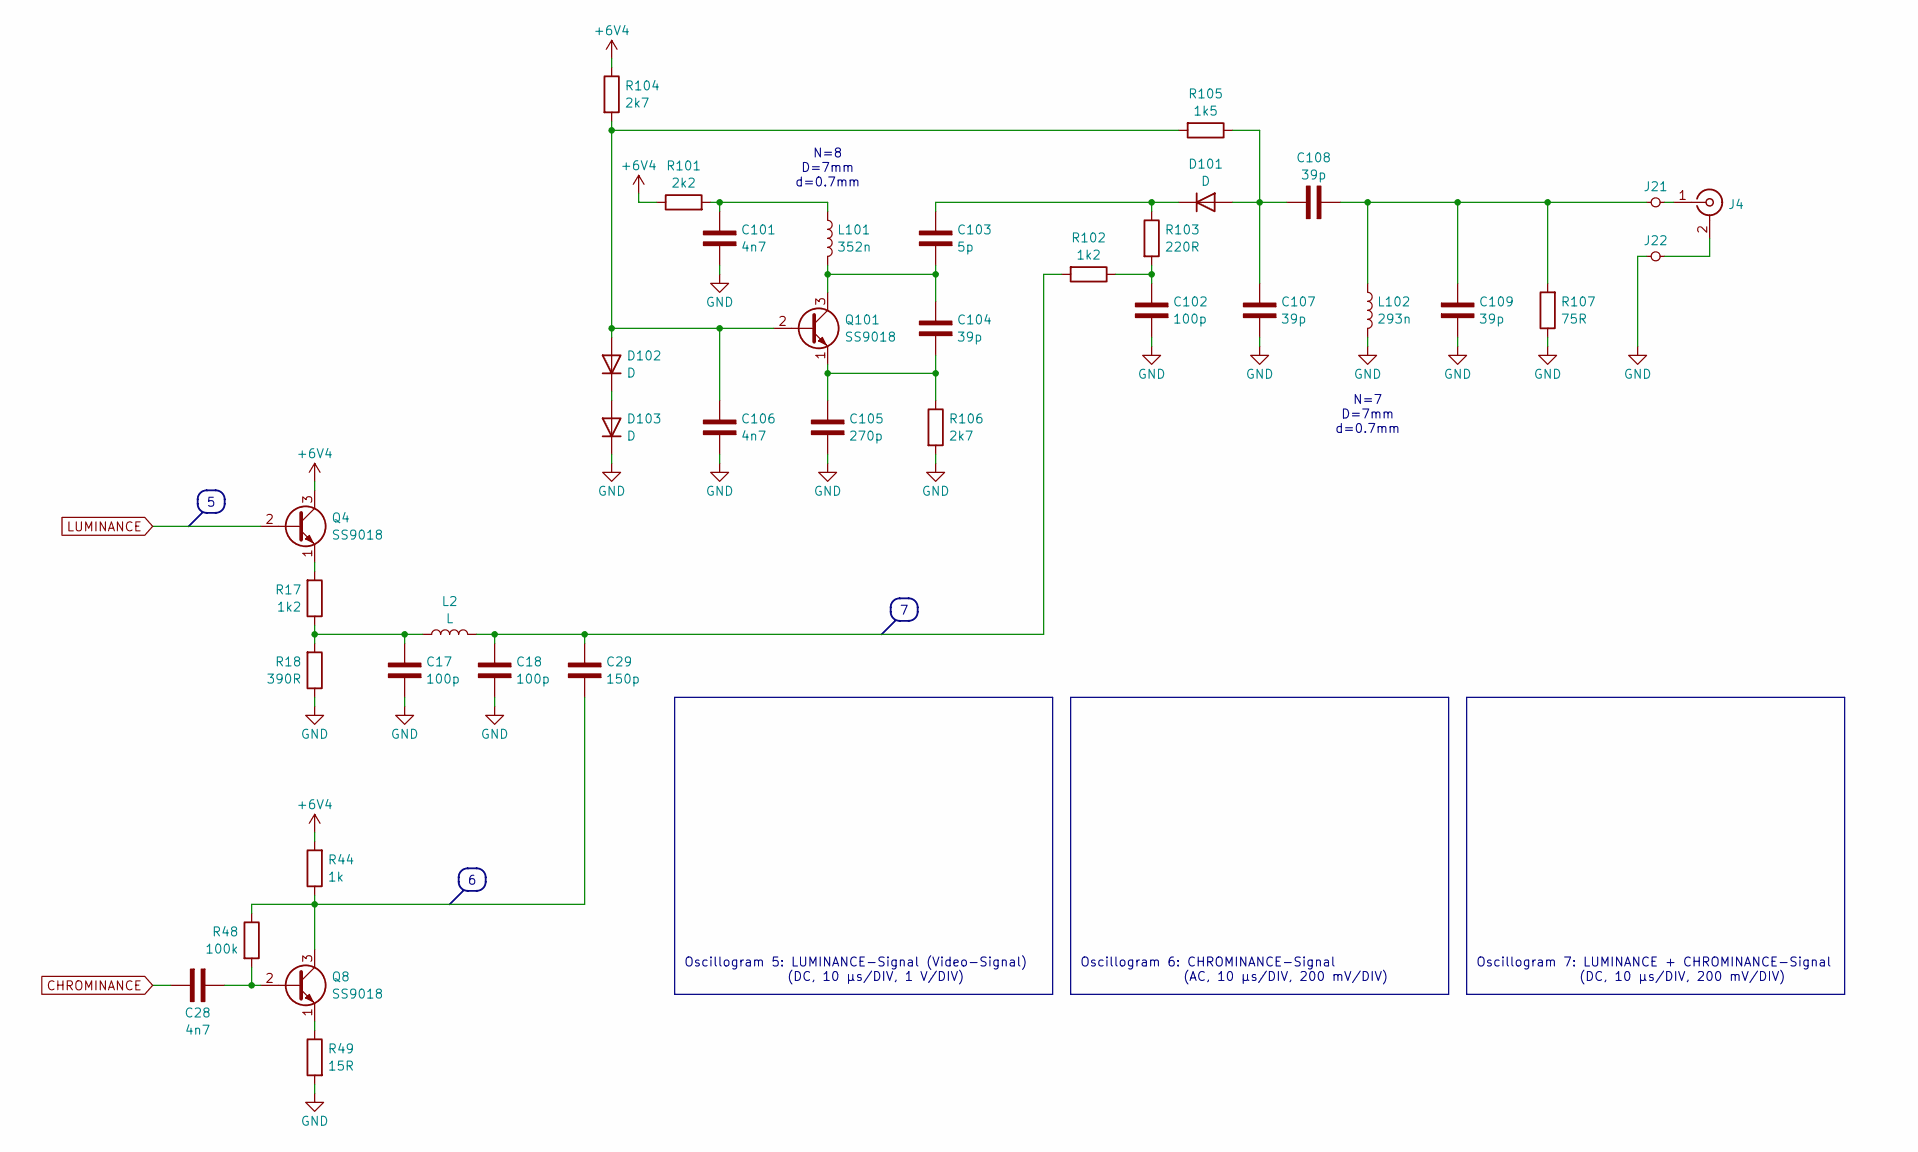
[picture p28: schematic RF-Stage VHF.kicad_sch]

Parts:
C17, C18, C102: 100p
C28, C101, C106: 4n7
C29: 150p
C103: 5p
C104, C107, C108, C109: 39p
C105: 270p
D101, D102, D103: D
J4: Conn_Coaxial
J21, J22: PCB_Conn
L2: L
L101: 352n
L102: 293n
Q4, Q8, Q101: SS9018
R17, R102: 1k2
R18: 390R
R44: 1k
R48: 100k
R49: 15R
R101: 2k2
R103: 220R
R104, R106: 2k7
R105: 1k5
R107: 75R

Connections:
+6V4: Q4.3 (C), R44.2, R101.1, R104.1
CHROMINANCE: C28.2
GND: C17.1, C18.1, C101.1, C102.1, C105.1, C106.1, C107.1, C109.2, D103.1 (K), J22.2 (Extern), L102.2, R18.1, R49.2, R106.2, R107.1
LUMINANCE: Q4.2 (B)
unnamed: C17.2, L2.1, R17.1, R18.2
unnamed: C18.2, C29.2, L2.2, R102.2
unnamed: C28.1, Q8.2 (B), R48.2
unnamed: C29.1, Q8.3 (C), R44.1, R48.1
unnamed: C101.2, L101.1, R101.2
unnamed: C102.2, R102.1, R103.2
unnamed: C103.1, C104.2, L101.2, Q101.3 (C)
unnamed: C103.2, D101.1 (K), R103.1
unnamed: C104.1, C105.2, Q101.1 (E), R106.1
unnamed: C106.2, D102.2 (A), Q101.2 (B), R104.2, R105.2
unnamed: C107.2, C108.1, D101.2 (A), R105.1
unnamed: C108.2, C109.1, J21.2 (Extern), L102.1, R107.2
unnamed: D102.1 (K), D103.2 (A)
unnamed: J4.1 (In), J21.1 (intern)
unnamed: J4.2 (Ext), J22.1 (intern)
unnamed: Q4.1 (E), R17.2
unnamed: Q8.1 (E), R49.1

Notes on the sheet:
Oscillogram 6: CHROMINANCE-Signal (AC, 10 µs/DIV, 200 mV/DIV)
N=7 D=7mm d=0.7mm
Oscillogram 7: LUMINANCE + CHROMINANCE-Signal (DC, 10 µs/DIV, 200 mV/DIV)
Oscillogram 5: LUMINANCE-Signal (Video-Signal) (DC, 10 µs/DIV, 1 V/DIV)
N=8 D=7mm d=0.7mm
