thoryn-dev/Soundic-SD-01-Schematic/kicad_schematic/Video-Generation.kicad_sch

## KiCad design kicad_schematic/Video-Generation.kicad_sch (2026-11-07, an earlier design)

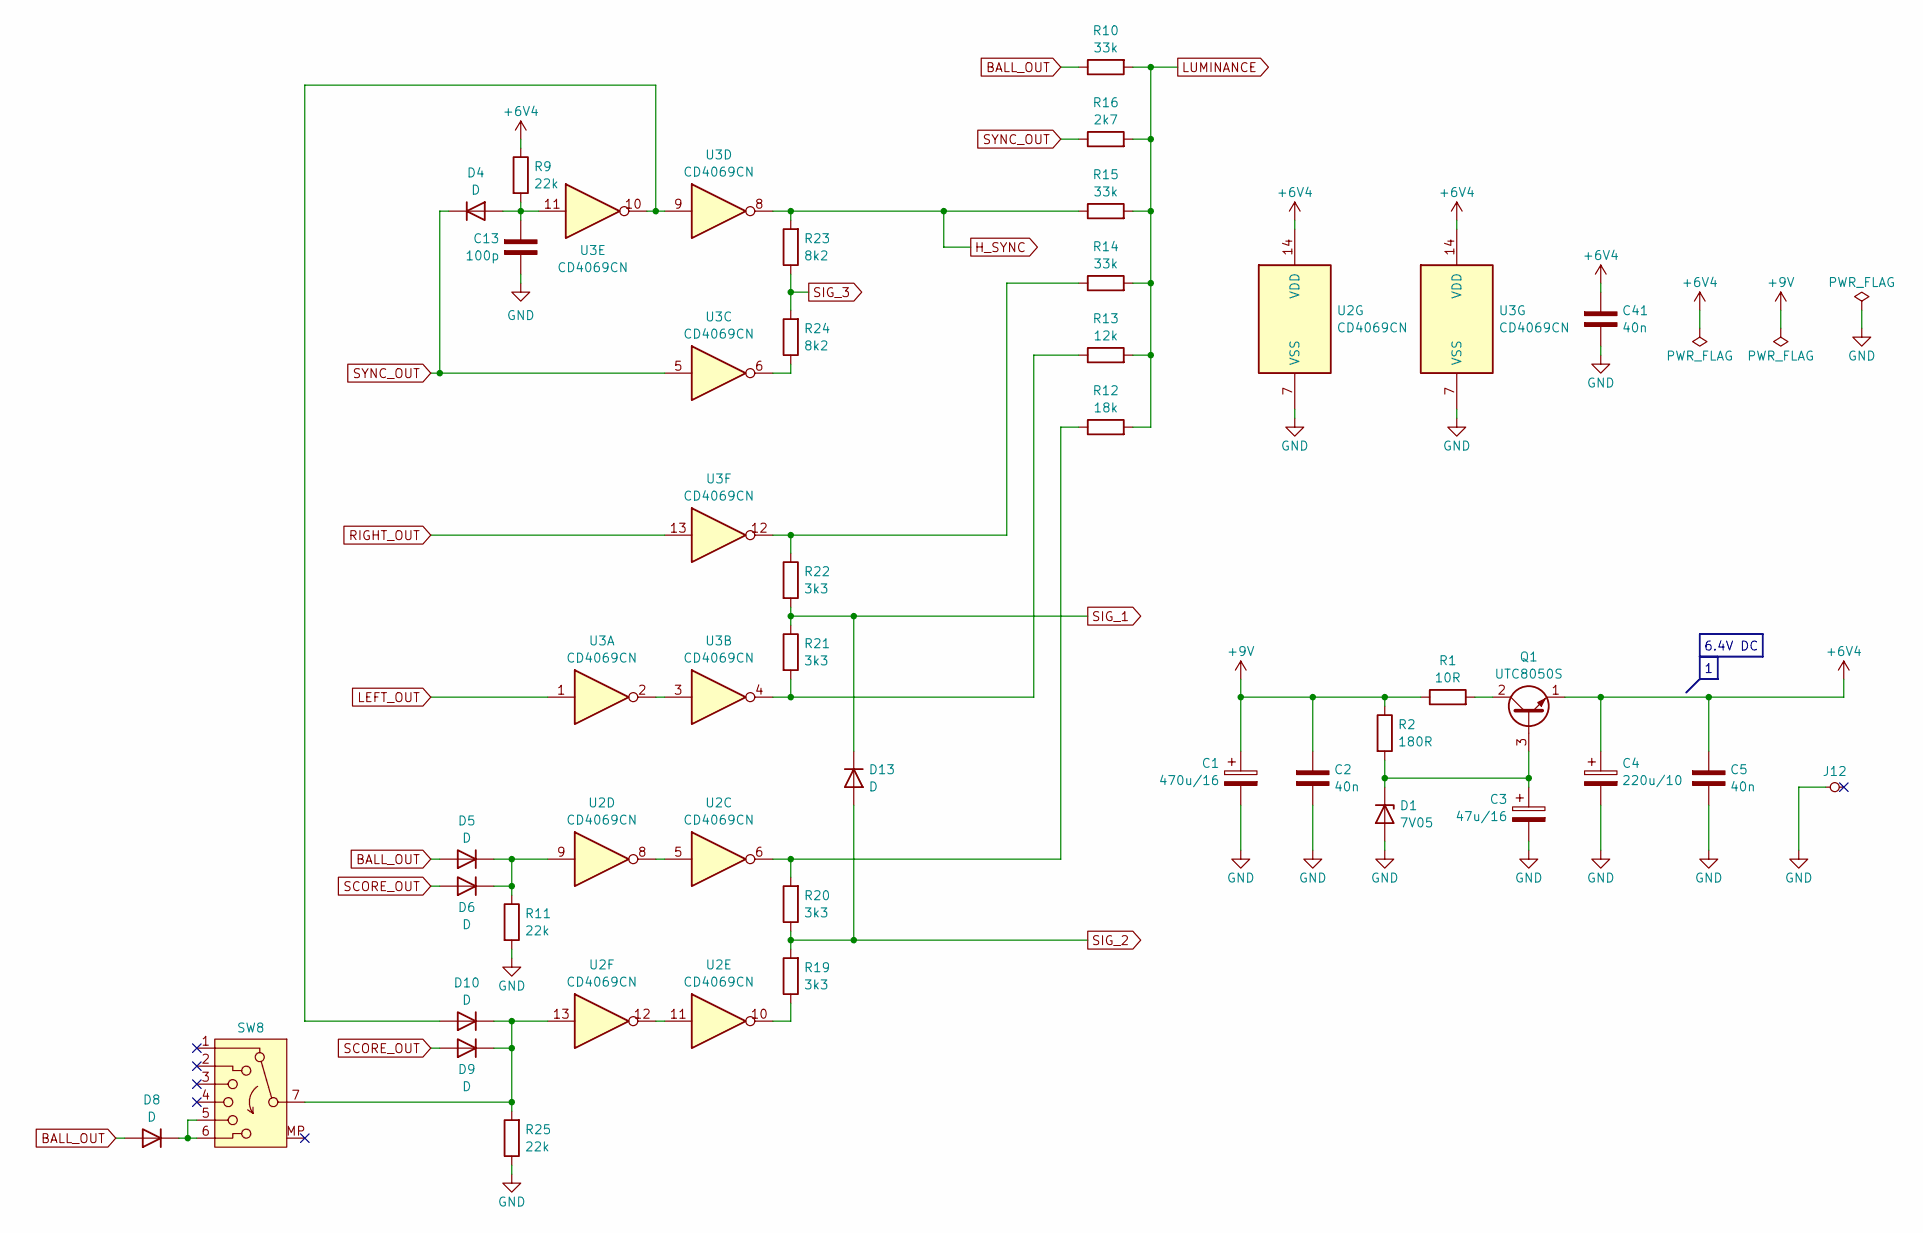
[picture p29: schematic Video-Generation.kicad_sch]

Parts:
C1: 470u/16
C2, C5, C41: 40n
C3: 47u/16
C4: 220u/10
C13: 100p
D1: 7V05
D4, D5, D6, D8, D9, D10, D13: D
J12: PCB_Conn
Q1: UTC8050S
R1: 10R
R2: 180R
R9, R11, R25: 22k
R10, R14, R15: 33k
R12: 18k
R13: 12k
R16: 2k7
R19, R20, R21, R22: 3k3
R23, R24: 8k2
SW8: SW_Rotary_1x6_MP
U2, U3: CD4069CN

Connections:
+6V4: C4.1, C5.1, C41.1, Q1.1 (E), R9.1, U2.14 (VDD), U3.14 (VDD)
+9V: C1.1, C2.1, R1.1, R2.1
BALL_OUT: D5.2 (A), D8.2 (A), R10.1
GND: C1.2, C2.2, C3.2, C4.2, C5.2, C13.2, C41.2, D1.2 (A), J12.1 (intern), R11.2, R25.1, U2.7 (VSS), U3.7 (VSS)
H_SYNC: R15.1, R23.2, U3.8
LEFT_OUT: U3.1
LUMINANCE: R10.2, R12.2, R13.2, R14.2, R15.2, R16.2
unnamed: C3.1, D1.1 (K), Q1.3 (B), R2.2
unnamed: C13.1, D4.2 (A), R9.2, U3.11
unnamed: D5.1 (K), D6.1 (K), R11.1, U2.9
unnamed: D8.1 (K), SW8.5, SW8.6
unnamed: D9.1 (K), D10.1 (K), R25.2, SW8.7, U2.13
unnamed: D10.2 (A), U3.9, U3.10
unnamed: Q1.2 (C), R1.2
unnamed: R12.1, R20.2, U2.6
unnamed: R13.1, R21.2, U3.4
unnamed: R14.1, R22.1, U3.12
unnamed: R19.1, U2.10
unnamed: R24.1, U3.6
unnamed: U2.5, U2.8
unnamed: U2.11, U2.12
unnamed: U3.2, U3.3
RIGHT_OUT: U3.13
SCORE_OUT: D6.2 (A), D9.2 (A)
SIG_1: D13.1 (K), R21.1, R22.2
SIG_2: D13.2 (A), R19.2, R20.1
SIG_3: R23.1, R24.2
SYNC_OUT: D4.1 (K), R16.1, U3.5

Notes on the sheet:
6.4V DC
