thoryn-dev/Soundic-SD-01-Schematic/(commit log)

2026-11-02 initial upload
    [CPU.kicad_sch, Color-Modulator.kicad_sch, RF-Stage.kicad_sch, Video-Generation.kicad_sch, kicad_schematic.kicad_pcb, kicad_schematic.kicad_sch]
2026-11-02 add UHF stage and error correction
    [Color-Modulator.kicad_sch, RF-Stage UHF.kicad_sch, RF-Stage VHF.kicad_sch, kicad_schematic.kicad_sch]
2026-11-07 some improvements and project cleanup
    [CPU.kicad_sch, Color-Modulator.kicad_sch, RF-Stage UHF.kicad_sch, RF-Stage VHF.kicad_sch, Video-Generation.kicad_sch, kicad_schematic.kicad_sch]
2026-11-07 License information added to circuit diagram and images
    [CPU.kicad_sch, Color-Modulator.kicad_sch, RF-Stage UHF.kicad_sch, RF-Stage VHF.kicad_sch, Video-Generation.kicad_sch, kicad_schematic.kicad_sch]
2026-11-07 style: improved schematic readability
    [CPU.kicad_sch, Color-Modulator.kicad_sch, RF-Stage UHF.kicad_sch, RF-Stage VHF.kicad_sch, Video-Generation.kicad_sch, kicad_schematic.kicad_sch]
