thoryn-dev/Soundic-SD-01-Schematic/(notices)

Notices in the files:
readme.md:
https://img.shields.io/badge/License:-CC0%201.0%20Universal-lightgrey
