thoryn-dev/Soundic-SD-01-Schematic/pictures/console backside.jpg

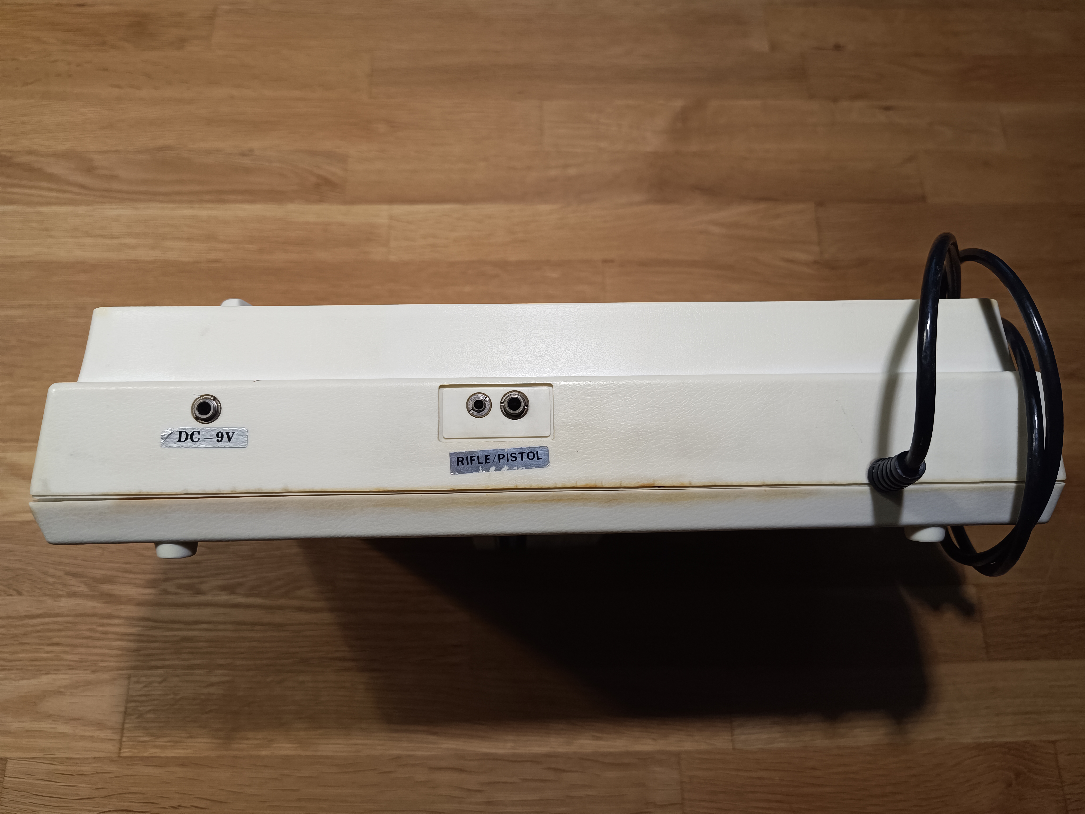
pictures/console backside.jpg
