thoryn-dev/Soundic-SD-01-Schematic/pictures/console bottom.jpg

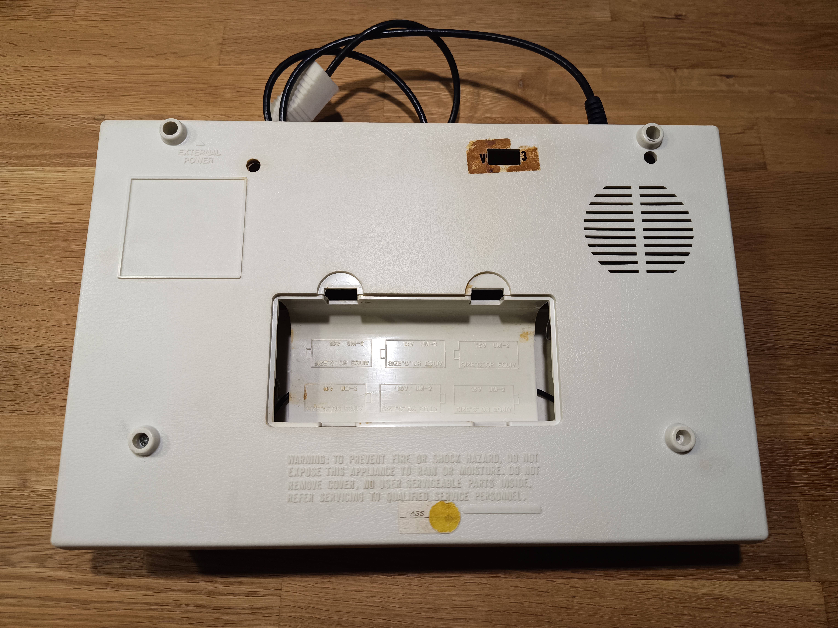
pictures/console bottom.jpg
