thoryn-dev/Soundic-SD-01-Schematic/pictures/console top.jpg

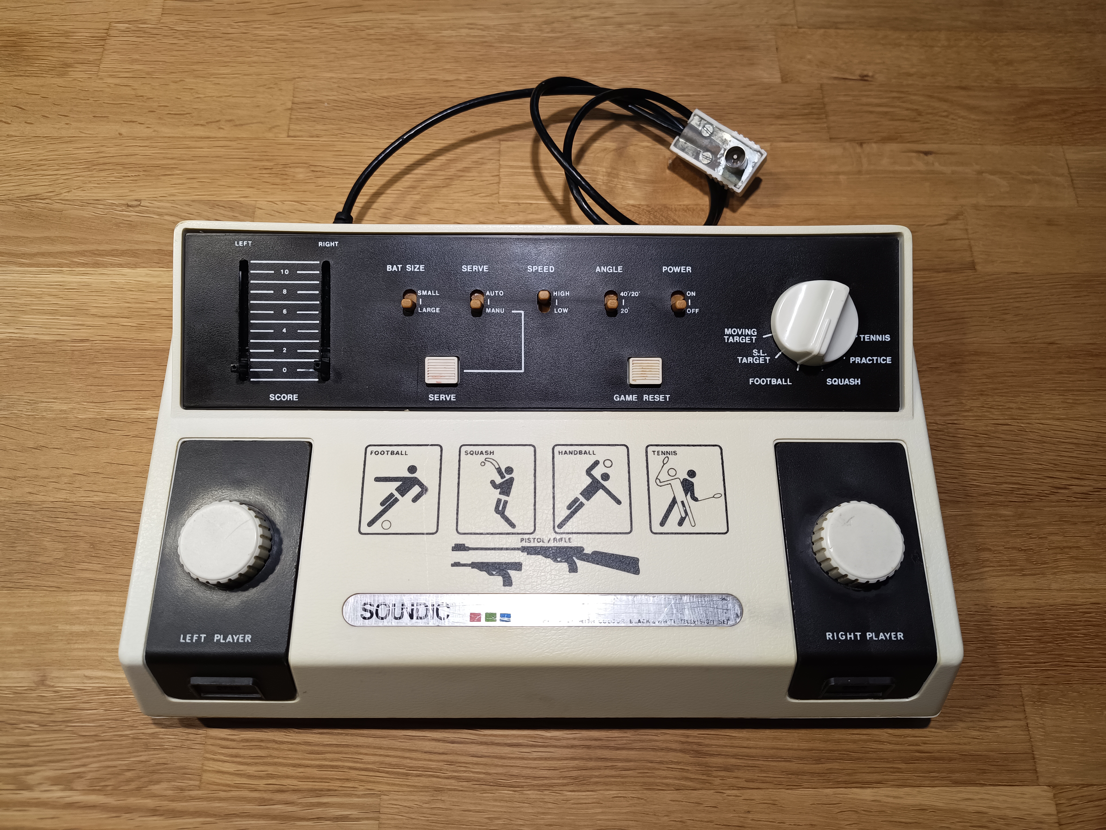
pictures/console top.jpg
