thoryn-dev/Soundic-SD-01-Schematic/pictures/assembly.jpg

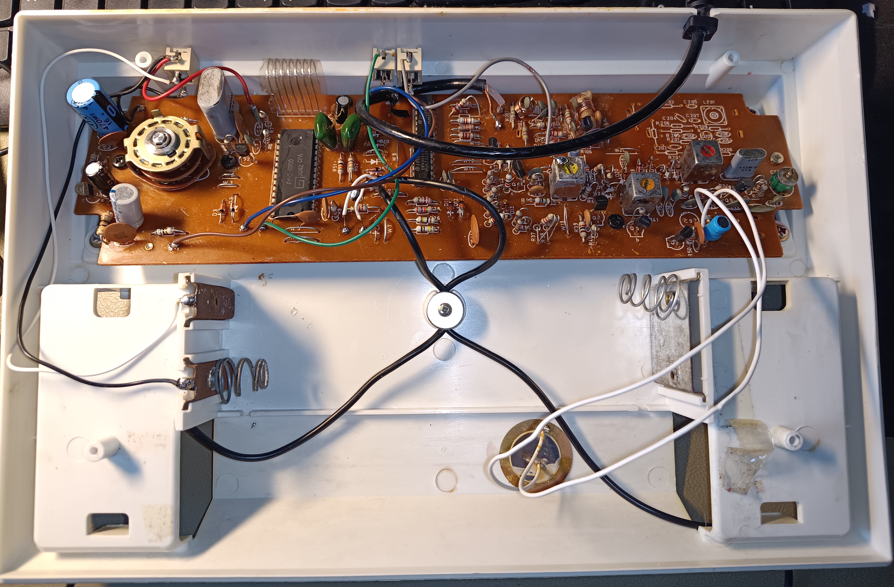
pictures/assembly.jpg
